e-xla/dodekaedri/README.md

# dodekaedri
dodekaedrin muotoinen radio ":D" /  dodecahedron shaped radio ":D"

------
This project aims to create truly affordable (<50€) 40m SSB QRP HAM radio kit.
Intention is to create such easy-approach kit that enables new (and old) HAMs to learn about radios, electronics and so on.

Some intended specs include:
* included SWR-meter
* ~5-10W of raw electromagnetic power
* graphical UI
* 2 mixer stages, one physical, one done with software

(Antenna not included)
