e-xla/dodekaedri/stm32/README

How to compile and program the STM32 software

Install arm-none-eabi-gcc, arm-none-eabi-binutils and arm-none-eabi-gdb.

Build stlink: https://github.com/texane/stlink

Download STM32F4 standard peripherals library: http://www.st.com/content/st_com/en/products/embedded-software/mcus-embedded-software/stm32-embedded-software/stm32-standard-peripheral-libraries/stsw-stm32065.html
Unzip the library and modify Makefile for the path to the library.

Run make

Start st-util: /path/to/stlink/build/st-util
arm-none-eabi-gdb dodekaedri.elf
Write these commands in gdb:
tar rem :4242
load
mon reset
continue
