e-xla/dodekaedri/hardware/dodekaedri.csv

Reference | Value | Footprint | Datasheet
R207 | 100R | Resistors_SMD:R_0805_HandSoldering
R205 | 100R | Resistors_SMD:R_0805_HandSoldering
R206 | 100R | Resistors_SMD:R_0805_HandSoldering
C202 | 100nF | Capacitors_SMD:C_0805_HandSoldering
C201 | 100nF | Capacitors_SMD:C_0805_HandSoldering
U201 | MIC5365 | TO_SOT_Packages_SMD:SOT-23-5
OSC201 | TCXO 26MHz | dodekaedri:TCXO_1.5x2mm
R201 | 1k | Resistors_SMD:R_0805_HandSoldering
R202 | 1k | Resistors_SMD:R_0805_HandSoldering
C203 | 1nF | Capacitors_SMD:C_0805_HandSoldering
C205 | 100nF | Capacitors_SMD:C_0805_HandSoldering
C204 | 100nF | Capacitors_SMD:C_0805_HandSoldering
U202 | SI5351A | Housings_SSOP:MSOP-10_3x3mm_Pitch0.5mm
R204 | 100R | Resistors_SMD:R_0805_HandSoldering
R203 | 100R | Resistors_SMD:R_0805_HandSoldering
P301 | BNC | dodekaedri:BNC_right_angle
C301 | 1nF | Capacitors_SMD:C_0805_HandSoldering
C302 | 1nF | Capacitors_SMD:C_0805_HandSoldering
L301 | 660nH | Air_Coils_SML_NEOSID:Neosid_Air-Coil_SML_5turn_HDM0531A
C304 | 1nF | Capacitors_SMD:C_0805_HandSoldering
C305 | 1nF | Capacitors_SMD:C_0805_HandSoldering
R302 | 47R | Resistors_SMD:R_0805_HandSoldering
R303 | 47R | Resistors_SMD:R_0805_HandSoldering
R301 | 7k87 | Resistors_SMD:R_0805_HandSoldering
D301 | BAT54SL | dodekaedri:SOT-23_HS_2-1-3
D302 | BAT54SL | dodekaedri:SOT-23_HS_2-1-3
D303 | BAT54SL | dodekaedri:SOT-23_HS_2-1-3
C307 | 1nF | Capacitors_SMD:C_0805_HandSoldering
C308 | 1nF | Capacitors_SMD:C_0805_HandSoldering
C309 | 100nF | Capacitors_SMD:C_0805_HandSoldering
C306 | 100nF | Capacitors_SMD:C_0805_HandSoldering
L303 | 1µ6 | Air_Coils_SML_NEOSID:Neosid_Air-Coil_SML_5turn_HDM0531A
D304 | BA891 | Diodes_SMD:SOD-523
R304 | 100k | Resistors_SMD:R_0805_HandSoldering
C311 | 330pF | Capacitors_SMD:C_0805_HandSoldering
D305 | BA891 | Diodes_SMD:SOD-523
R305 | 100R | Resistors_SMD:R_0805_HandSoldering
C310 | 10nF | Capacitors_SMD:C_0805_HandSoldering
L304 | 470µH | dodekaedri:SMT_1007
D306 | BA891 | Diodes_SMD:SOD-523
T302 | TRANSFO | dodekaedri:TRANSF_pads
T301 | TRANSFO | dodekaedri:TRANSF_pads
R307 | 1k | Resistors_SMD:R_0805_HandSoldering
R306 | 1k | Resistors_SMD:R_0805_HandSoldering
R308 | 1k | Resistors_SMD:R_0805_HandSoldering
R309 | 1k | Resistors_SMD:R_0805_HandSoldering
U401 | NCP3170-D | Housings_SOIC:SOIC-8_3.9x4.9mm_Pitch1.27mm
C403 | 6n8 | Capacitors_SMD:C_0805_HandSoldering
C402 | 10µF | Capacitors_SMD:C_0805_HandSoldering
C404 | 10µF | Capacitors_SMD:C_0805_HandSoldering
L402 | 100µH | dodekaedri:psu_ind
R403 | 24k9 | Resistors_SMD:R_0805_HandSoldering
R404 | 7k87 | Resistors_SMD:R_0805_HandSoldering
R402 | 4k99 | Resistors_SMD:R_0805_HandSoldering
CON401 | BARREL_JACK | Connect:BARREL_JACK
W401 | TEST_1P | Measurement_Points:Measurement_Point_Round-SMD-Pad_Big
C401 | 10µF | Capacitors_SMD:C_0805_HandSoldering
C405 | 10µF | Capacitors_SMD:C_0805_HandSoldering
R401 | 100k | Resistors_SMD:R_0805_HandSoldering
D401 | 824520141 | Diodes_SMD:SMA_Handsoldering
FB401 | FILTER | Resistors_SMD:R_0805_HandSoldering
FB402 | FILTER | Resistors_SMD:R_0805_HandSoldering
D402 | MSP3V3 | dodekaedri:Micro_SMP
U501 | 74LVC1G3157 | TO_SOT_Packages_SMD:SOT-23-6_Handsoldering
U502 | 74LVC1G3157 | TO_SOT_Packages_SMD:SOT-23-6_Handsoldering
T501 | TRANSFO2 | dodekaedri:transf_5_pin
C501 | 220µF | dodekaedri:CAP_6.3x5.8mm
C502 | 100nF | Capacitors_SMD:C_0805_HandSoldering
L501 | 1µH | Air_Coils_SML_NEOSID:Neosid_Air-Coil_SML_5turn_HDM0531A
C503 | 330pF | Capacitors_SMD:C_0805_HandSoldering
C504 | 10nF | Capacitors_SMD:C_0805_HandSoldering
Q501 | BCP56 | TO_SOT_Packages_SMD:SOT-223
R504 | 10R | Resistors_SMD:R_0805_HandSoldering
C505 | 100nF | Capacitors_SMD:C_0805_HandSoldering
C506 | 10nF | Capacitors_SMD:C_0805_HandSoldering
C507 | 10nF | Capacitors_SMD:C_0805_HandSoldering
R506 | 1k | Resistors_SMD:R_0805_HandSoldering
R505 | 0.1pF | Resistors_SMD:R_0805_HandSoldering
Q502 | IRL510 | TO_SOT_Packages_THT:TO-220_Neutral123_Vertical
L502 | 1µH | Air_Coils_SML_NEOSID:Neosid_Air-Coil_SML_5turn_HDM0531A
C509 | 100nF | Capacitors_SMD:C_0805_HandSoldering
R508 | 0R1 | Resistors_SMD:R_0805_HandSoldering
L503 | 800nH | Air_Coils_SML_NEOSID:Neosid_Air-Coil_SML_5turn_HDM0531A
C512 | 330pF | Capacitors_SMD:C_0805_HandSoldering
C513 | 1nF | Capacitors_SMD:C_0805_HandSoldering
R502 | 1k | Resistors_SMD:R_0805_HandSoldering
C511 | 10nF | Capacitors_SMD:C_0805_HandSoldering
R509 | 1k | Resistors_SMD:R_0805_HandSoldering
C508 | 10nF | Capacitors_SMD:C_0805_HandSoldering
C510 | 10nF | Capacitors_SMD:C_0805_HandSoldering
R507 | 1k | Resistors_SMD:R_0805_HandSoldering
R510 | 1k | Resistors_SMD:R_0805_HandSoldering
R501 | 1k | Resistors_SMD:R_0805_HandSoldering
FB501 | FILTER | Resistors_SMD:R_0805_HandSoldering
R511 | 100k | Resistors_SMD:R_0805_HandSoldering
D501 | RED | LEDs:LED_0805
R512 | 100R | Resistors_SMD:R_0805_HandSoldering
R513 | 100R | Resistors_SMD:R_0805_HandSoldering
C514 | 1nF | Capacitors_SMD:C_0805_HandSoldering
C515 | 1nF | Capacitors_SMD:C_0805_HandSoldering
FB502 | FILTER | Resistors_SMD:R_0805_HandSoldering
T601 | TRANSFO2 | dodekaedri:transf_5_pin
U601 | 74LVC1G3157 | TO_SOT_Packages_SMD:SOT-23-6_Handsoldering
U602 | 74LVC1G3157 | TO_SOT_Packages_SMD:SOT-23-6_Handsoldering
R601 | 100R | Resistors_SMD:R_0805_HandSoldering
R602 | 100R | Resistors_SMD:R_0805_HandSoldering
C602 | 68nF | Capacitors_SMD:C_0805_HandSoldering
C603 | 68nF | Capacitors_SMD:C_0805_HandSoldering
C605 | 68nF | Capacitors_SMD:C_0805_HandSoldering
C604 | 68nF | Capacitors_SMD:C_0805_HandSoldering
L601 | 470µH | dodekaedri:SMT_1007
L603 | 470µH | dodekaedri:SMT_1007
L602 | 470µH | dodekaedri:SMT_1007
L604 | 470µH | dodekaedri:SMT_1007
U603 | TL972IDR | Housings_SOIC:SOIC-8_3.9x4.9mm_Pitch1.27mm
R603 | 100R | Resistors_SMD:R_0805_HandSoldering
R604 | 100R | Resistors_SMD:R_0805_HandSoldering
C601 | 100nF | Capacitors_SMD:C_0805_HandSoldering
C606 | 1nF | Capacitors_SMD:C_0805_HandSoldering
C607 | 1nF | Capacitors_SMD:C_0805_HandSoldering
R605 | 1k | Resistors_SMD:R_0805_HandSoldering
R606 | 1k | Resistors_SMD:R_0805_HandSoldering
C608 | 100nF | Capacitors_SMD:C_0805_HandSoldering
U701 | WM8731 | Housings_SSOP:SSOP-28_5.3x10.2mm_Pitch0.65mm
C701 | 10µF | Capacitors_SMD:C_0805_HandSoldering
C702 | 10µF | Capacitors_SMD:C_0805_HandSoldering
C703 | 10µF | Capacitors_SMD:C_0805_HandSoldering
C704 | 10µF | Capacitors_SMD:C_0805_HandSoldering
R701 | 0.1pF | Resistors_SMD:R_0805_HandSoldering
R702 | 0.1pF | Resistors_SMD:R_0805_HandSoldering
C705 | 10µF | Capacitors_SMD:C_0805_HandSoldering
U702 | MCP6L02 | Housings_SOIC:SOIC-8_3.9x4.9mm_Pitch1.27mm
R703 | 1k | Resistors_SMD:R_0805_HandSoldering
R704 | 0R | Resistors_SMD:R_0805_HandSoldering
R705 | 0R | Resistors_SMD:R_0805_HandSoldering
C805 | 100nF | Capacitors_SMD:C_0805_HandSoldering
C807 | 100nF | Capacitors_SMD:C_0805_HandSoldering
C801 | 100nF | Capacitors_SMD:C_0805_HandSoldering
C810 | 100nF | Capacitors_SMD:C_0805_HandSoldering
C806 | 100nF | Capacitors_SMD:C_0805_HandSoldering
C809 | 100nF | Capacitors_SMD:C_0805_HandSoldering
C803 | 10µF | Capacitors_SMD:C_0805_HandSoldering
U802 | WM8731 | Housings_SSOP:SSOP-28_5.3x10.2mm_Pitch0.65mm
C812 | 10µF | Capacitors_SMD:C_0805_HandSoldering
C813 | 10µF | Capacitors_SMD:C_0805_HandSoldering
C814 | 10µF | Capacitors_SMD:C_0805_HandSoldering
C815 | 10µF | Capacitors_SMD:C_0805_HandSoldering
R810 | 0.1pF | Resistors_SMD:R_0805_HandSoldering
R811 | 0.1pF | Resistors_SMD:R_0805_HandSoldering
C818 | 10µF | Capacitors_SMD:C_0805_HandSoldering
R812 | 1k | Resistors_SMD:R_0805_HandSoldering
R816 | 1k | Resistors_SMD:R_0805_HandSoldering
R818 | 100R | Resistors_SMD:R_0805_HandSoldering
C819 | 220µF | dodekaedri:CAP_6.3x5.8mm
C816 | 220µF | dodekaedri:CAP_6.3x5.8mm
C817 | 1nF | Capacitors_SMD:C_0805_HandSoldering
C820 | 1nF | Capacitors_SMD:C_0805_HandSoldering
J801 | HANDSFREE | dodekaedri:TRRS_jack
J803 | HEADPHONES
J802 | microphone
R815 | 1k | Resistors_SMD:R_0805_HandSoldering
R814 | 1k | Resistors_SMD:R_0805_HandSoldering
R808 | 100k | Resistors_SMD:R_0805_HandSoldering
D814 | MSP3V3 | dodekaedri:Micro_SMP
C802 | 1nF | Capacitors_SMD:C_0805_HandSoldering
Q801 | BSS84 | TO_SOT_Packages_SMD:SOT-23_Handsoldering
R803 | 100k | Resistors_SMD:R_0805_HandSoldering
P801 | TX_SW_WIRE | Connect:AK300-2
SW801 | SW_PUSH | Buttons_Switches_SMD:SW_SPST_B3SL-1002P
R801 | 100k | Resistors_SMD:R_0805_HandSoldering
C804 | 1nF | Capacitors_SMD:C_0805_HandSoldering
R802 | 1k | Resistors_SMD:R_0805_HandSoldering
R804 | 1k | Resistors_SMD:R_0805_HandSoldering
D801 | BAT54SL | TO_SOT_Packages_SMD:SOT-23_Handsoldering
D803 | BAT54SL | TO_SOT_Packages_SMD:SOT-23_Handsoldering
D804 | BAT54SL | TO_SOT_Packages_SMD:SOT-23_Handsoldering
FB802 | FILTER | Resistors_SMD:R_0805_HandSoldering
FB803 | FILTER | Resistors_SMD:R_0805_HandSoldering
FB801 | FILTER | Resistors_SMD:R_0805_HandSoldering
D805 | BAT54SL | dodekaedri:SOT-23_HS_2-1-3
D806 | BAT54SL | dodekaedri:SOT-23_HS_2-1-3
D807 | BAT54SL | dodekaedri:SOT-23_HS_2-1-3
SW802 | SW | Buttons_Switches_SMD:SW_SPST_B3SL-1002P
SW803 | SW | Buttons_Switches_SMD:SW_SPST_B3SL-1002P
SW804 | SW | Buttons_Switches_SMD:SW_SPST_B3SL-1002P
D809 | BAT54SL | dodekaedri:SOT-23_HS_2-1-3
D812 | BAT54SL | dodekaedri:SOT-23_HS_2-1-3
D810 | BAT54SL | dodekaedri:SOT-23_HS_2-1-3
SW806 | encoder | dodekaedri:encoder
R806 | 1k | Resistors_SMD:R_0805_HandSoldering
R809 | 1k | Resistors_SMD:R_0805_HandSoldering
P806 | CONN_01X08 | Pin_Headers:Pin_Header_Straight_1x08
U801 | STM32F401 | Housings_QFP:LQFP-64_10x10mm_Pitch0.5mm
P807 | CONN_01X04 | Pin_Headers:Pin_Header_Straight_1x04
P808 | CONN_02X04 | Pin_Headers:Pin_Header_Straight_2x04
R819 | 100R | Resistors_SMD:R_0805_HandSoldering
C808 | 10µF | Capacitors_SMD:C_0805_HandSoldering
C811 | 10µF | Capacitors_SMD:C_0805_HandSoldering
R820 | 1k | Resistors_SMD:R_0805_HandSoldering
R821 | 1k | Resistors_SMD:R_0805_HandSoldering
R805 | 100k | Resistors_SMD:R_0805_HandSoldering
P809 | BOOT0JMPR | Pin_Headers:Pin_Header_Straight_1x02
R807 | 100k | Resistors_SMD:R_0805_HandSoldering
SW807 | RESET | Buttons_Switches_SMD:SW_SPST_B3SL-1002P
P803 | UART | Pin_Headers:Pin_Header_Straight_1x02
P804 | PROG | Pin_Headers:Pin_Header_Straight_1x02
P805 | RNG_PINS | Pin_Headers:Pin_Header_Straight_2x08
D802 | PMEG6020EP | Diodes_SMD:D_0805
D823 | BAT54SL | TO_SOT_Packages_SMD:SOT-23_Handsoldering
R830 | 1k | Resistors_SMD:R_0805_HandSoldering
R831 | 1k | Resistors_SMD:R_0805_HandSoldering
R832 | 1k | Resistors_SMD:R_0805_HandSoldering
R833 | 1k | Resistors_SMD:R_0805_HandSoldering
R834 | 1k | Resistors_SMD:R_0805_HandSoldering
R835 | 1k | Resistors_SMD:R_0805_HandSoldering
R825 | 1k | Resistors_SMD:R_0805_HandSoldering
R826 | 1k | Resistors_SMD:R_0805_HandSoldering
R827 | 1k | Resistors_SMD:R_0805_HandSoldering
R828 | 1k | Resistors_SMD:R_0805_HandSoldering
D819 | BAT54SL | TO_SOT_Packages_SMD:SOT-23_Handsoldering
D820 | BAT54SL | TO_SOT_Packages_SMD:SOT-23_Handsoldering
D822 | BAT54SL | TO_SOT_Packages_SMD:SOT-23_Handsoldering
D821 | BAT54SL | TO_SOT_Packages_SMD:SOT-23_Handsoldering
R823 | 100R | Resistors_SMD:R_0805_HandSoldering
R824 | 100R | Resistors_SMD:R_0805_HandSoldering
D818 | BAT54SL | TO_SOT_Packages_SMD:SOT-23_Handsoldering
P802 | USB_OTG | Connect:USB_Micro-B
R822 | 7k87 | Resistors_SMD:R_0805_HandSoldering
R813 | 100k | Resistors_SMD:R_0805_HandSoldering
