e-xla/dodekaedri/hardware/bom_v1.ods

Value | Count | devices | count multi | handled | Multi price | total | References | Mouser (old) | New | (alternative) | Nice to have features / comments
0.1pF | 5 | 25 | 125 | x | 0 | 0 | R505" "R701" "R702" "R810" "R811
0R | 2 | 25 | 50 | 100 | 0 | 0 | R704" "R705 | 667-ERJ-6GEY0R00V | 667-ERJ-6GEY0R00V (http://www.mouser.fi/ProductDetail/Panasonic/ERJ-6GEY0R00V/?qs=sGAEpiMZZMtlubZbdhIBIGGkozl1QdRpbM2mlUXXIDw%3D)
0R1 | 1 | 25 | 25 | 100 | 0 | 0 | R508 | 774-73L3R10J | 774-73L3R10J (http://www.mouser.fi/ProductDetail/CTS-Electronic-Components/73L3R10J/)
100R | 16 | 25 | 400 | 1000 | 0 | 0 | R207" "R205" "R206" "R204" "R203" "R305" "R512" "R513" "R601" "R602" "R603" "R604" "R818" "R819" "R823" "R824 | 588-AS08J1000ET | 755-ESR10EZPJ101 (http://www.mouser.fi/ProductDetail/ROHM-Semiconductor/ESR10EZPJ101/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)
100k | 9 | 25 | 225 | 300 | 0 | 0 | R304" "R401" "R511" "R808" "R803" "R801" "R805" "R807" "R813 | 588-AS08J1003ET | 603-RC0805JR-07100KL (http://www.mouser.fi/ProductDetail/Yageo/RC0805JR-07100KL/?qs=sGAEpiMZZMtlubZbdhIBILYKDyqiSVLql9IYbXdvrms%3D)
100nF | 17 | 25 | 425 | k | 0 | 0 | C202" "C201" "C205" "C204" "C309" "C306" "C502" "C505" "C509" "C601" "C608" "C805" "C807" "C801" "C810" "C806" "C809 | 710-885012207072 | from club
100µH | 1 | 25 | 25 | 10 | 0 | 0 | L402 | ASPI-4030S-101M-T | out of stock :( | 652-SRN4018-101M (http://www.mouser.fi/ProductDetail/Bourns/SRN4018-101M/)
10R | 1 | 25 | 25 | k | 0 | 0 | R504 | 588-AS08J10R0ET | from club (8.2R)
10nF | 7 | 25 | 175 | k | 0 | 0 | C310" "C504" "C506" "C507" "C511" "C508" "C510 | 710-885012207011 | from club
10µF | 17 | 25 | 425 | 100 | 0 | 0 | C402" "C404" "C401" "C405" "C701" "C702" "C703" "C704" "C705" "C803" "C812" "C813" "C814" "C815" "C818" "C808" "C811 | 81-GRM21BR61A106KE19 | 81-GRM21BR61A106KE19 (http://www.mouser.fi/ProductDetail/Murata-Electronics/GRM21BR61A106KE19L/)
1k | 35 | 25 | 875 | 1000 | 0 | 0 | R201" "R202" "R307" "R306" "R308" "R309" "R506" "R502" "R509" "R507" "R510" "R501" "R605" "R606" "R703" "R812" "R816" "R815" "R814" "R802" "R804" "R806" "R809" "R820" "R821" "R830" "R831" "R832" "R833" "R834" "R835" "R825" "R826" "R827" "R828 | 588-AS08J1001ET | 603-RC0805FR-071KL (http://www.mouser.fi/ProductDetail/Yageo/RC0805FR-071KL/?qs=sGAEpiMZZMu61qfTUdNhG0IfGdGRhTL5jwjd7Z4phgo%3D)
1nF | 16 | 25 | 400 | 500 | 0 | 0 | C203" "C301" "C302" "C304" "C305" "C307" "C308" "C513" "C514" "C515" "C606" "C607" "C817" "C820" "C802" "C804 | 581-08053F102K4T2A | 581-08055A102J (http://www.mouser.fi/ProductDetail/AVX/08055A102JAT2A/) |  | NP0
1µ6 | 1 | 25 | 25 | k | 0 | 0 | L303 |  | homewound
1µH | 2 | 25 | 50 | k | 0 | 0 | L501" "L502 |  | homewound
220µF | 3 | 25 | 75 | 100 | 0 | 0 | C501" "C819" "C816 | 647-UUR1A221MCL6GS | 647-UUR1A221MCL6GS (http://www.mouser.fi/ProductDetail/Nichicon/UUR1A221MCL6GS/)
24k9 | 1 | 25 | 25 | 100 | 0 | 0 | R403 | 71-CRCW0805-24.9K-E3 | 603-RC0805FR-0724K9L (http://www.mouser.fi/ProductDetail/Yageo/RC0805FR-0724K9L/?qs=sGAEpiMZZMtlubZbdhIBIJv49G1poxg99uEn6bmXK1I%3D) |  | 1,00%
330pF | 3 | 25 | 75 | k | 0 | 0 | C311" "C503" "C512 | 80-C0805C331K5R | from club |  | NP0
470µH | 5 | 25 | 125 | 0 | 0 | 0 | L304" "L601" "L603" "L602" "L604 | LB2518T471K | 963-LB2518T471K (http://www.mouser.fi/ProductDetail/Taiyo-Yuden/LB2518T471K/)
47R | 2 | 25 | 50 | 100 | 0 | 0 | R302" "R303 | 755-ESR10EZPJ470 | ( 603-RC0805FR-0747RL ) (http://www.mouser.fi/ProductDetail/Yageo/RC0805FR-0747RL/) | RC0805FR-0751RL (51ohm, better) (http://www.mouser.fi/ProductDetail/Yageo/RC0805FR-0751RL/?qs=sGAEpiMZZMtlubZbdhIBIKnsynxCetJ5q2IVS85if1M%3D) | changed to 51 ohm
4k99 | 1 | 25 | 25 | 100 | 0 | 0 | R402 | 667-ERJ-6ENF4991V | 603-RC0805FR-074K99L (http://www.mouser.fi/ProductDetail/Yageo/RC0805FR-074K99L/) |  | 1,00%
660nH | 1 | 25 | 25 | k | 0 | 0 | L301 |  | homewound
68nF | 4 | 25 | 100 | 100 | 0 | 0 | C602" "C603" "C605" "C604 | 710-885012207097 |  | 810-CGA4J1C0G2A333J2 (http://www.mouser.fi/ProductDetail/TDK/CGA4J1C0G2A333J125AC/) | NP0 → changed to 33 nF
6n8 | 1 | 25 | 25 | 10 | 0 | 0 | C403 | 08051C682KAT2A | 810-C2012C0G1H682J-1 (http://www.mouser.fi/ProductDetail/TDK/C2012C0G1H682J060AA/) |  | (NP0?)
74LVC1G3157 | 4 | 25 | 100 | 10 | 0 | 0 | U501" "U502" "U601" "U602 | SN74LVC1G3157DBVR | 621-74LVC1G3157DW-7 (http://www.mouser.fi/ProductDetail/Diodes-Incorporated/74LVC1G3157DW-7/)
7k87 | 3 | 25 | 75 | 100 | 0 | 0 | R301" "R404" "R822 | 603-RC0805FR-077K87L | 603-RC0805FR-077K87L (http://www.mouser.fi/ProductDetail/Yageo/RC0805FR-077K87L/) |  | 1,00%
800nH | 1 | 25 | 25 | k | 0 | 0 | L503 |  | homewound
824520141 | 1 | 25 | 25 | 10 | 0 | 0 | D401 | 824520141 | 710-824520141 (http://www.mouser.fi/ProductDetail/Wurth-Electronics/824520141/)
BA891 | 3 | 25 | 75 | 10 | 0 | 0 | D304" "D305" "D306 |  | 771-BA891-T/R (http://www.mouser.fi/ProductDetail/NXP-Semiconductors/BA891115/)
BARREL_JACK | 1 | 25 | 25 | 1 | 0 | 0 | CON401 | PJ-002A | 490-PJ-002A (http://www.mouser.fi/ProductDetail/CUI/PJ-002A/)
BAT54SL | 18 | 25 | 450 | 100 | 0 | 0 | D301" "D302" "D303" "D801" "D803" "D804" "D805" "D806" "D807" "D809" "D812" "D810" "D823" "D819" "D820" "D822" "D821" "D818 | BAT54SLT1G | 863-BAT54SLT1G (http://www.mouser.fi/ProductDetail/ON-Semiconductor/BAT54SLT1G/)
BCP56 | 1 | 25 | 25 | 4 | 0 | 0 | Q501 | BCP56 |  | 771-PZT2222A115 (faster) (http://www.mouser.fi/ProductDetail/NXP-Semiconductors/PZT2222A115/)
BNC | 1 | 25 | 25 | 1 | 0 | 0 | P301 | 112416 | 523-112416 (http://www.mouser.fi/ProductDetail/Amphenol-RF/112416/) | TME 1-1337494-0
BOOT0JMPR | 1 | 25 | 25 | ? | 0 | 0 | P809 |  | piikkirimaa!
BSS84 | 1 | 25 | 25 | 4 | 0 | 0 | Q801 | BSS84 | 726-BSS84PH6327XTSA2 (http://www.mouser.fi/ProductDetail/Infineon-Technologies/BSS84PH6327XTSA2/)
CONN_01X04 | 1 | 25 | 25 | ? | 0 | 0 | P807 |  | piikkirimaa!
CONN_01X08 | 1 | 25 | 25 | ? | 0 | 0 | P806 |  | piikkirimaa!
CONN_02X04 | 1 | 25 | 25 | ? | 0 | 0 | P808 |  | piikkirimaa!
FILTER | 7 | 25 | 175 | 0 | 0 | 0 | FB401" "FB402" "FB501" "FB502" "FB802" "FB803" "FB801 | 2508056007Y3 | 623-2508056007Y3 (http://www.mouser.fi/ProductDetail/Fair-Rite/2508056007Y3/?qs=sGAEpiMZZMtdyQheitOmRdlbrKoV7Kcr1qkGgD009vc%3D)
HANDSFREE | 1 | 25 | 25 | 1 | 0 | 0 | J801 | SJ-43515TS | 490-SJ-43515TS (http://www.mouser.fi/ProductDetail/CUI/SJ-43515TS/)
HEADPHONES | 0 | 25 | 0 | 0 | 0 | 0 | J803 |  | not in current layout
IRL510 | 1 | 25 | 25 | 5 | 0 | 0 | Q502 | IRL510 | 844-IRL510PBF (http://www.mouser.fi/ProductDetail/Vishay-Semiconductors/IRL510PBF/)
MCP6L02 | 1 | 25 | 25 | 3 | 0 | 0 | U702 | MCP6L02T-E/SN | 579-MCP6L02T-E/SN (http://www.mouser.fi/ProductDetail/Microchip-Technology/MCP6L02T-E-SN/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) | ( 579-MCP6002T-I/SN ) (http://www.mouser.fi/ProductDetail/Microchip-Technology/MCP6002T-I-SN/)
MIC5365 | 0 | 25 | 0 | 0 | 0 | 0 | U201 |  | not needed anymore
MSP3V3 | 2 | 25 | 50 | 10 | 0 | 0 | D402" "D814 | MSP3V3-M3/89A | 625-MSP3V3-M3 (http://www.mouser.fi/ProductDetail/Vishay-Semiconductors/MSP3V3-M3-89A/)
NCP3170-D | 1 | 25 | 25 | 2 | 0 | 0 | U401 | NCP3170ADR2G | 863-NCP3170ADR2G (http://www.mouser.fi/ProductDetail/ON-Semiconductor/NCP3170ADR2G/?qs=sGAEpiMZZMubXWjzskHvc9vqwOVbsQe%2F)
PMEG6020EP | 1 | 25 | 25 | 2 | 0 | 0 | D802 | PMEG6020EPASX | 581-SD0805S020S1R0 (http://www.mouser.fi/ProductDetail/AVX/SD0805S020S1R0/)
PROG | 1 | 25 | 25 | ? | 0 | 0 | P804 |  | piikkirimaa!
RED | 1 | 25 | 25 | 10 | 0 | 0 | D501 | HSMH-C170 | 604-AP2012EC (http://www.mouser.fi/ProductDetail/Kingbright/AP2012EC/?qs=sGAEpiMZZMseGfSY3csMkfJS7xWFNN5nHOYjTU5HAhY%3D)
RESET | 0 | 25 | 0 | 0 | 0 | 0 | SW807 | LL3301DF065QJ | included in SW
RNG_PINS | 1 | 25 | 25 | ? | 0 | 0 | P805 |  | piikkirimaa!
SI5351A | 1 | 25 | 25 | 4 | 0 | 0 | U202 | 634-SI5351A-B-GT | 634-SI5351A-B-GT (http://www.mouser.fi/ProductDetail/Silicon-Labs/SI5351A-B-GT/)
STM32F401 | 1 | 25 | 25 | 2 | 0 | 0 | U801 | STM32F401RE | 511-STM32F401RET6 (http://www.mouser.fi/ProductDetail/STMicroelectronics/STM32F401RET6/)
SW | 5 | 25 | 125 | 3 | 0 | 0 | SW802" "SW803" "SW804 | LL3301DF065QJ | 612-LL3301DF065QJ (http://www.mouser.fi/ProductDetail/E-Switch/LL3301DF065QJ/?qs=sGAEpiMZZMvxtGF7dlGNpqqmTFthXBmf2IHkMbm6UkQ%3D) |  | Includes RESET and SW_PUSH | tilattaneen tme_ltä !!
SW_PUSH | 0 | 25 | 0 | 0 | 0 | 0 | SW801 | LL3301DF065QJ | included in SW
TCXO 26MHz | 1 | 25 | 25 | 3 | 0 | 0 | OSC201 | KT2520K26000ZAW18TAS | 581-KT2520K2ACW18TAS (http://www.mouser.fi/ProductDetail/AVX-Kyocera/KT2520K26000ACW18TAS/)
TEST_1P | 0 | 25 | 0 | 0 | 0 | 0 | W401 |  | not a component
TL972IDR | 1 | 25 | 25 | 0 | 0 | 0 | U603 | TL972IDR | 595-TL972IDR (http://www.mouser.fi/ProductDetail/Texas-Instruments/TL972IDR/)
TRANSFO | 2 | 25 | 50 | 100 | 0 | 0 | T302" "T301 |  | 623-5943000101 + homewound (http://www.mouser.fi/ProductDetail/Fair-Rite/5943000101/)
TRANSFO2 | 2 | 25 | 50 | 0 | 0 | 0 | T501" "T601 | ETC4-1-2TR | 937-ETC4-1-2TR (http://www.mouser.fi/ProductDetail/MACOM/ETC4-1-2TR/) | partcon tarjous
TX_SW_WIRE | 0 | 25 | 0 | 0 | 0 | 0 | P801 |  | optional, not included
UART | 1 | 25 | 25 | ? | 0 | 0 | P803 |  | piikkirimaa!
USB_OTG | 1 | 25 | 25 | 2 | 0 | 0 | P802 | 538-67503-1020 | 538-67503-1020 (http://www.mouser.fi/ProductDetail/Molex/67503-1020/)
WM8731 | 2 | 25 | 50 | 4 | 0 | 0 | U701" "U802 | WM8731SEDS/V | 238-WM8731SEDS/V (http://www.mouser.fi/ProductDetail/Cirrus-Logic/WM8731SEDS-V/?qs=sGAEpiMZZMthNezIpKscMWquczdXLZMI)
encoder | 1 | 25 | 25 | 2 | 0 | 0 | SW806 | EN12-HS22AF20 | 858-EN12-HS22AF20 (http://www.mouser.fi/ProductDetail/BI-Technologies-TT-Electronics/EN12-HS22AF20/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)
microphone | 0 | 25 | 0 | 0 | 0 | 0 | J802 |  | not in current layout
knob | 1 | 25 | 25 | 1 | 0 | 0 | ?? |  | 706-11K5014-KCNG (http://www.mouser.fi/Search/ProductDetail.aspx) | etsitään halvempaa, muuten tämä
