e-xla/dodekaedri/pcb_plots/dodekaedri-F.SilkS.pdf

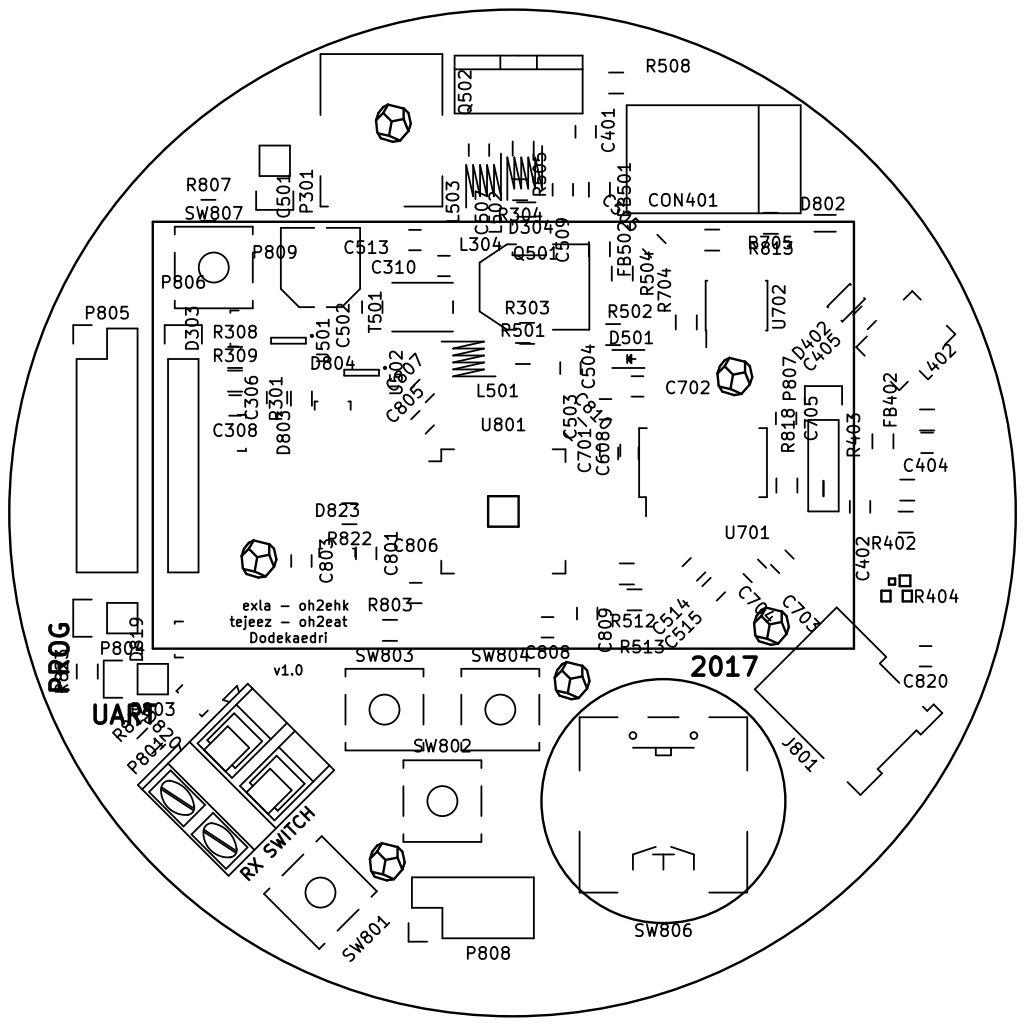
[picture p1: page 1]

tejeez - oh2eat Dodekaedri v1.0 RX SWITCH UART PROG
