e-xla/dodekaedri/pcb_plots/dodekaedri.pdf

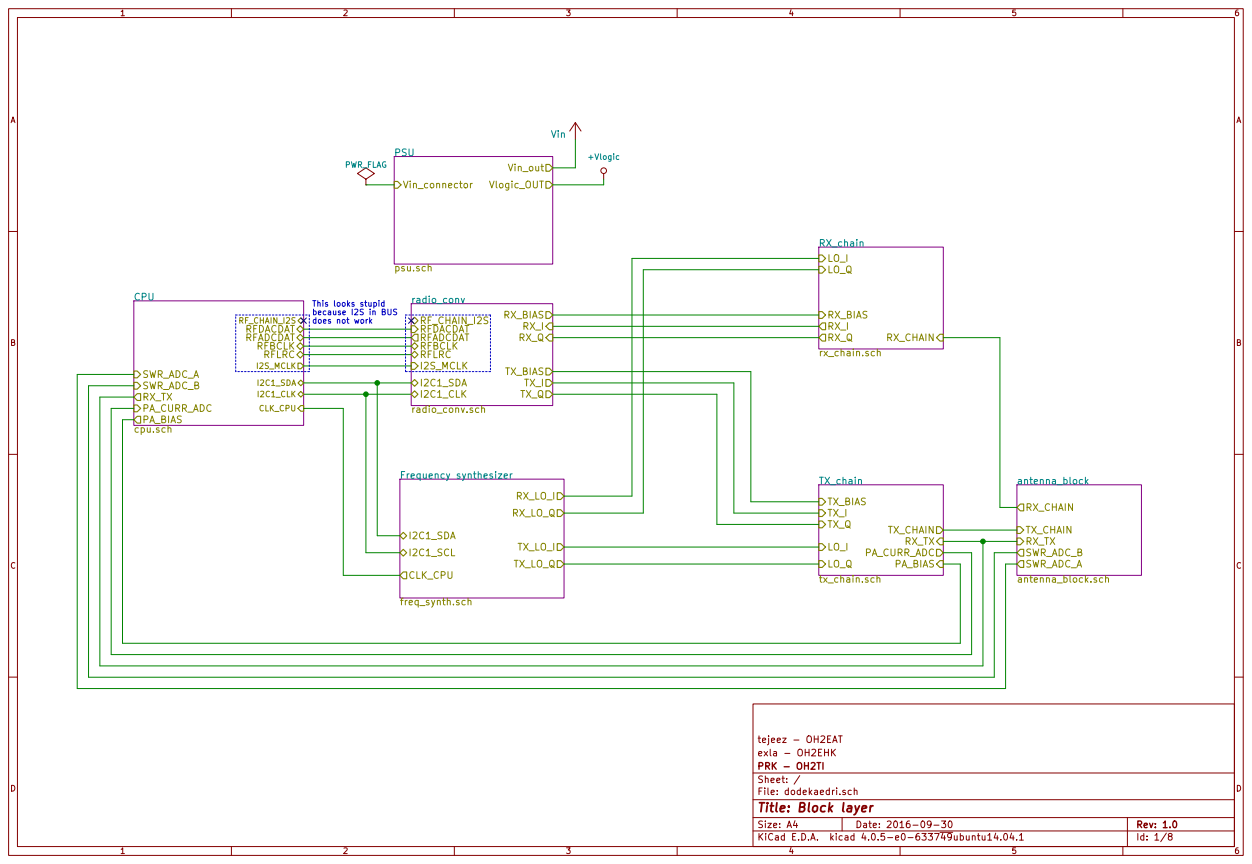
[picture p2: page 1]

tejeez - OH2EAT
Id: 1/8 Title: Block layer File: dodekaedri.sch Sheet: / PRK - OH2TI exla - OH2EHK

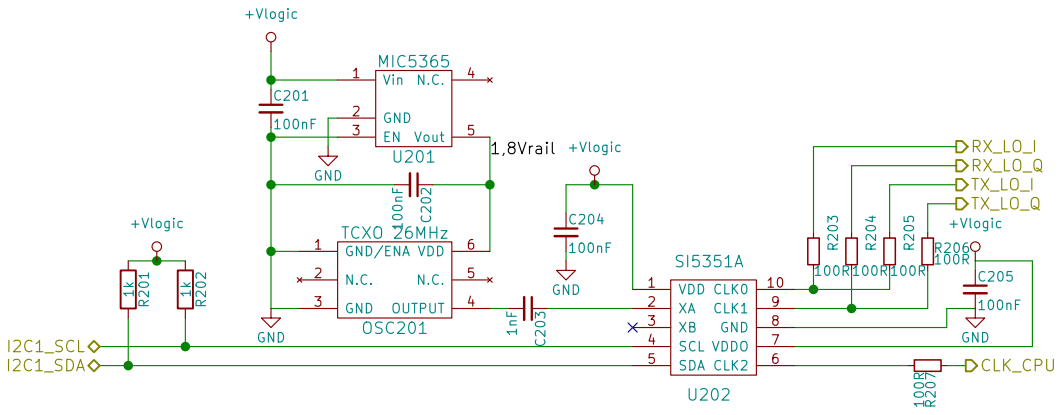
[picture p3: page 2]

tejeez - OH2EAT
Sheet: /Frequency synthesizer/ PRK - OH2TI exla - OH2EHK

File: freq_synth.sch
Id: 2/8 Title: Frequency synthesizer for LOs and CPU clock generation

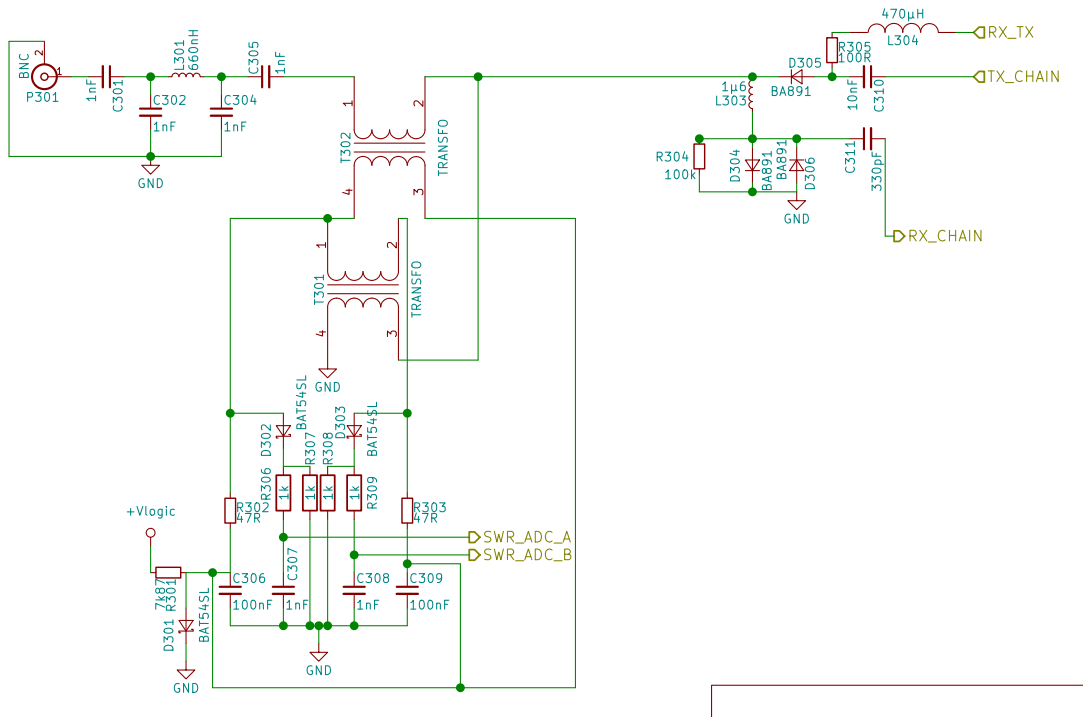
[picture p4: page 3]

File: antenna_block.sch
Id: 3/8 Title: Antenna block, SWR-meter and RXTX switch

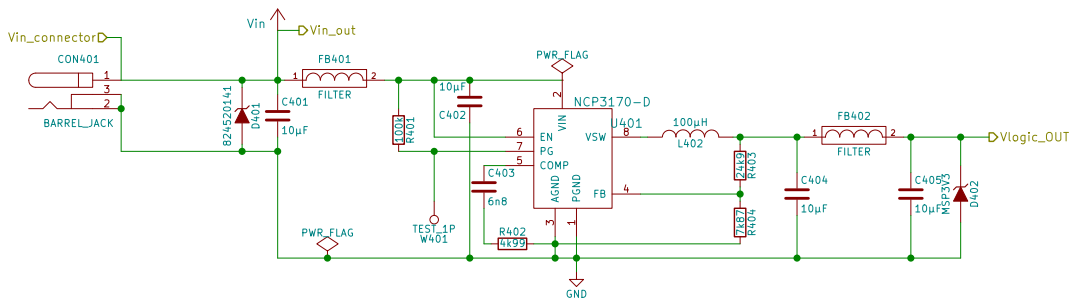
[picture p5: page 4]

3 FB 4 COMP 5 EN 6 PG 7 VSW 8 U401 NCP3170-D

File: psu.sch Sheet: /PSU/ PRK - OH2TI exla - OH2EHK

Id: 4/8 Title: Power supply unit

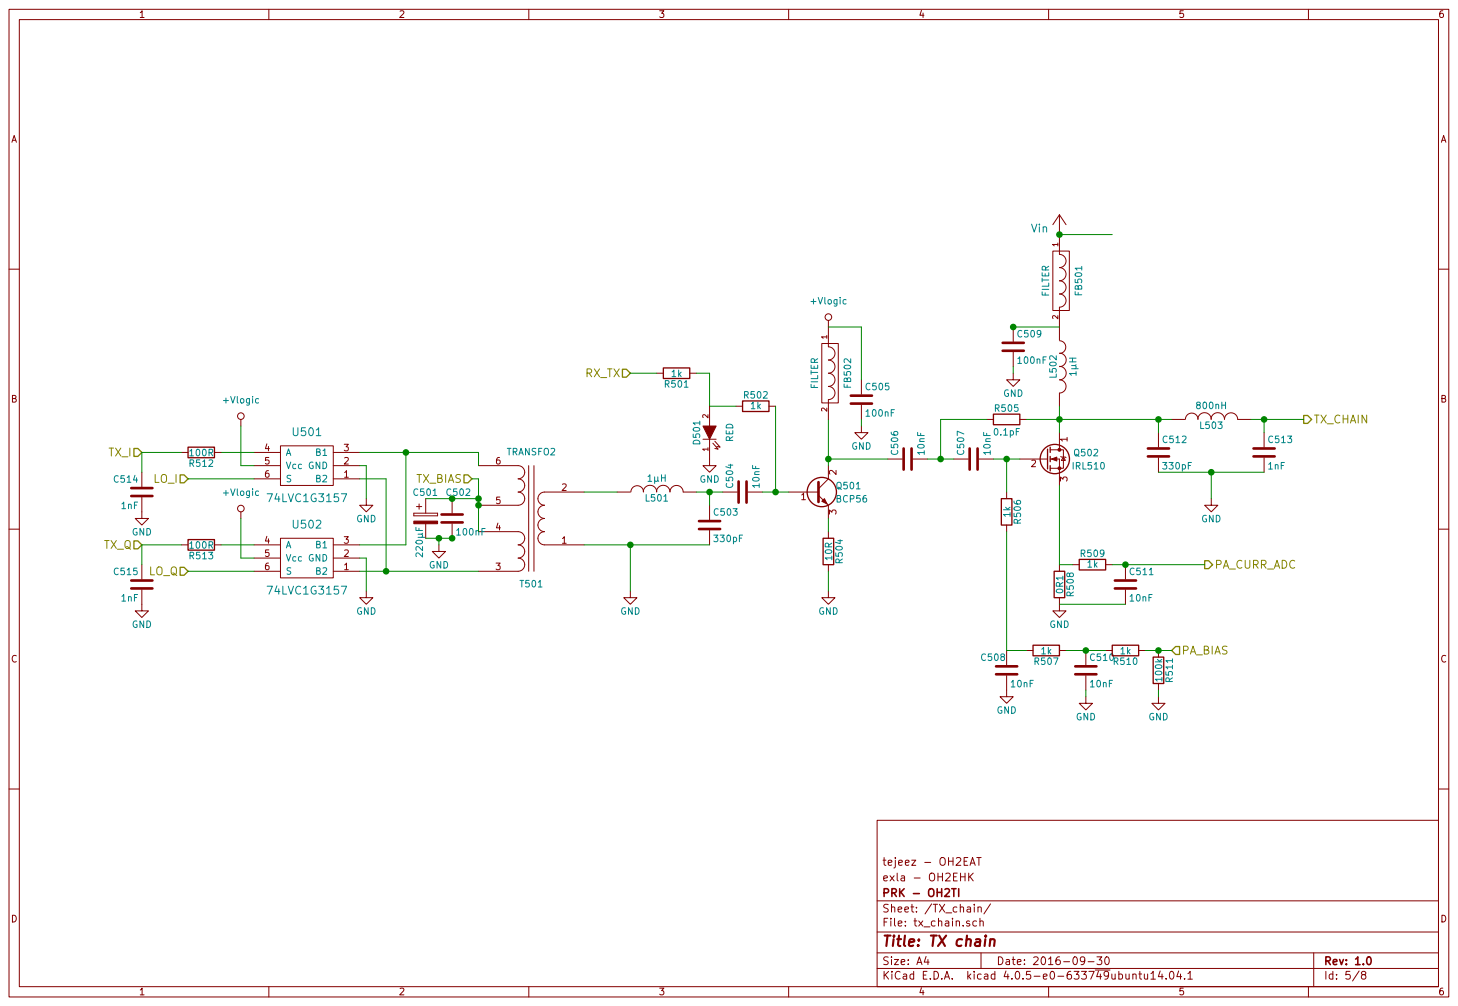
[picture p6: page 5]

File: tx_chain.sch
Id: 5/8 Title: TX chain

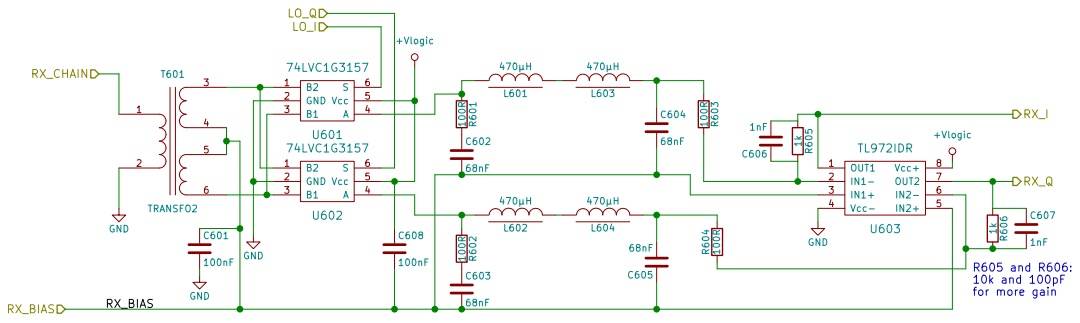
[picture p7: page 6]

File: rx_chain.sch
Id: 6/8 Title: RX chain

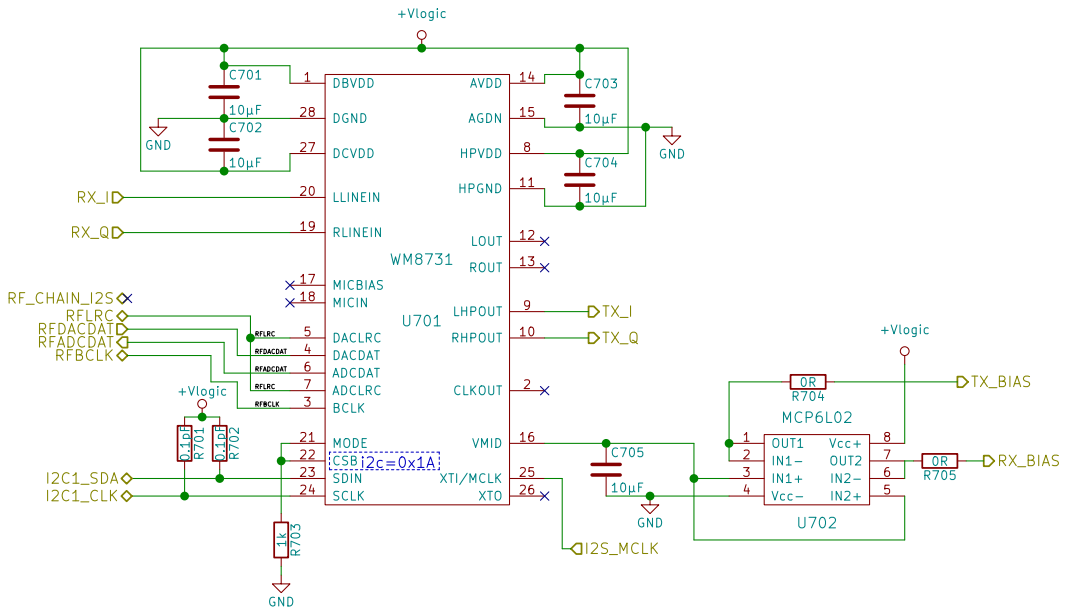
[picture p8: page 7]

File: radio_conv.sch
Id: 7/8 Title: RF chain ADC/DAC

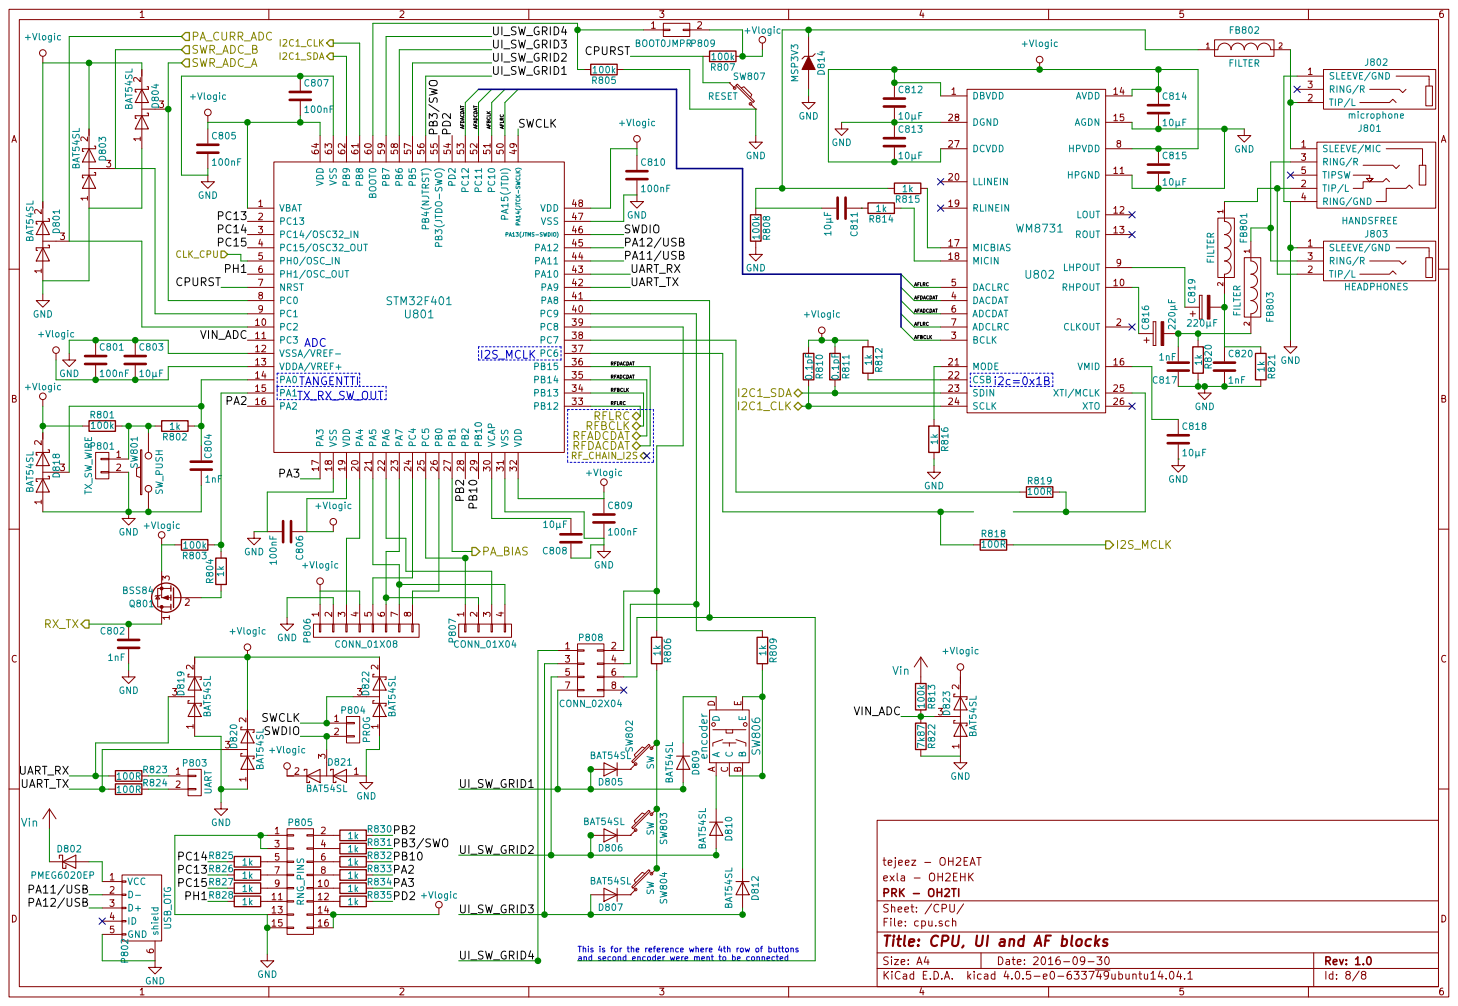
[picture p9: page 8]

TANGENTTI
TX_RX_SW_OUT

tejeez - OH2EAT
File: cpu.sch Sheet: /CPU/ PRK - OH2TI exla - OH2EHK

Id: 8/8 Title: CPU, UI and AF blocks
