e-xla/dodekaedri/pcb_plots/dodekaedri-B.Cu.pdf

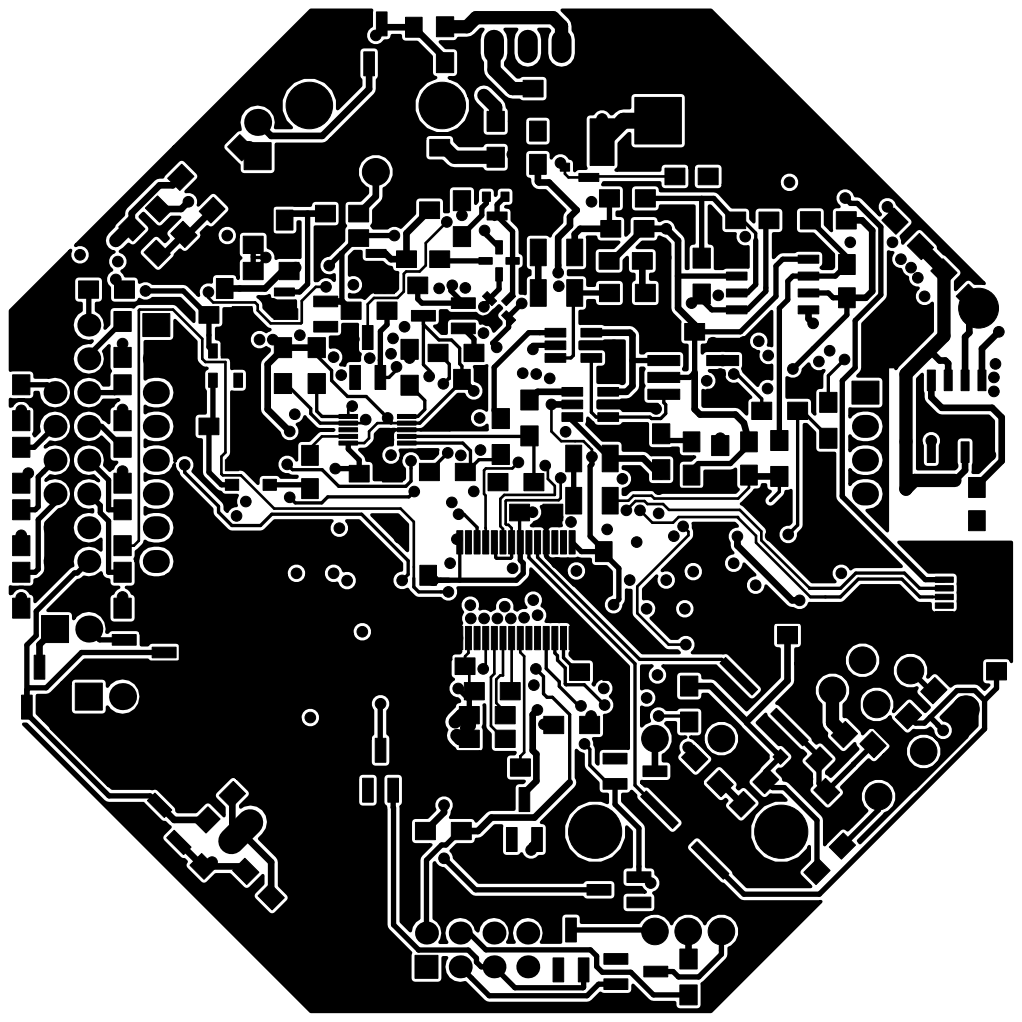
[picture p10: page 1]
