e-xla/dodekaedri/pcb_plots/dodekaedri-B.SilkS.pdf

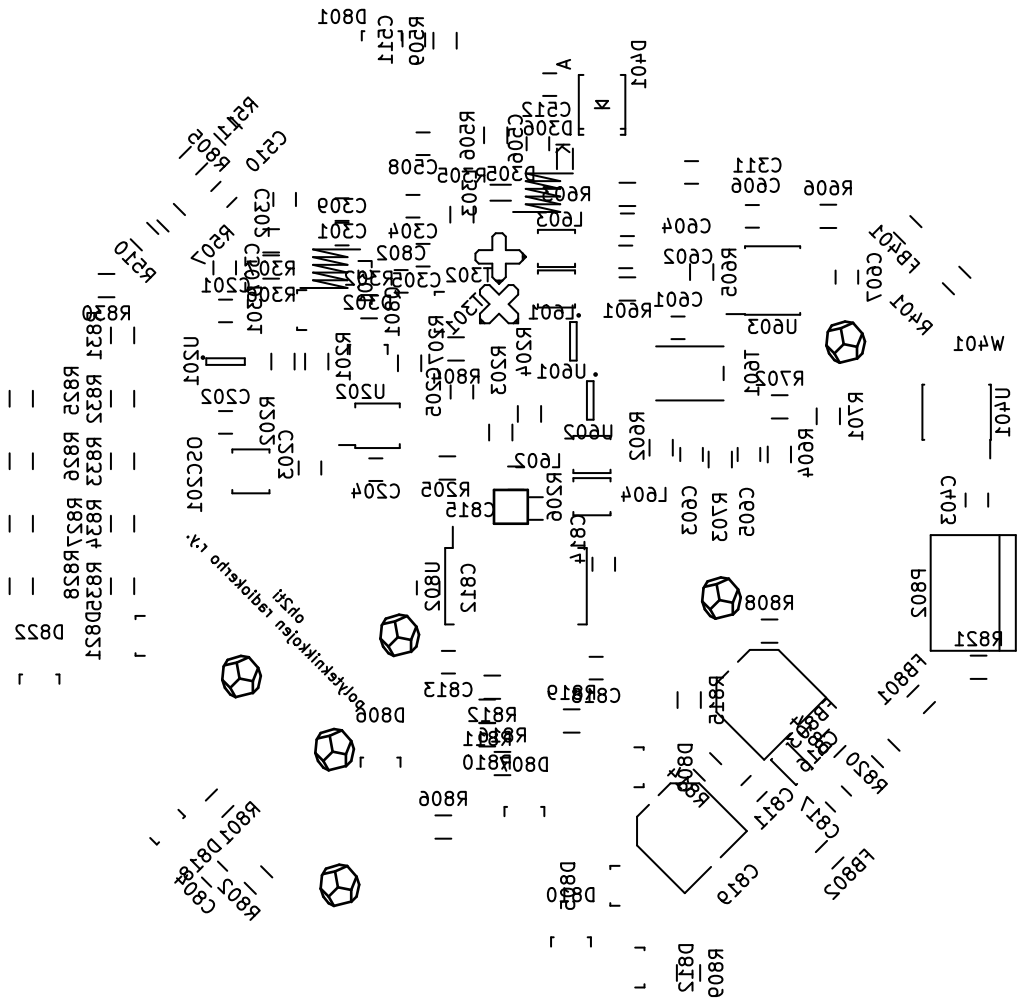
[picture p11: page 1]
