e-xla/dodekaedri/pcb_plots/dodekaedri-F.Cu.pdf

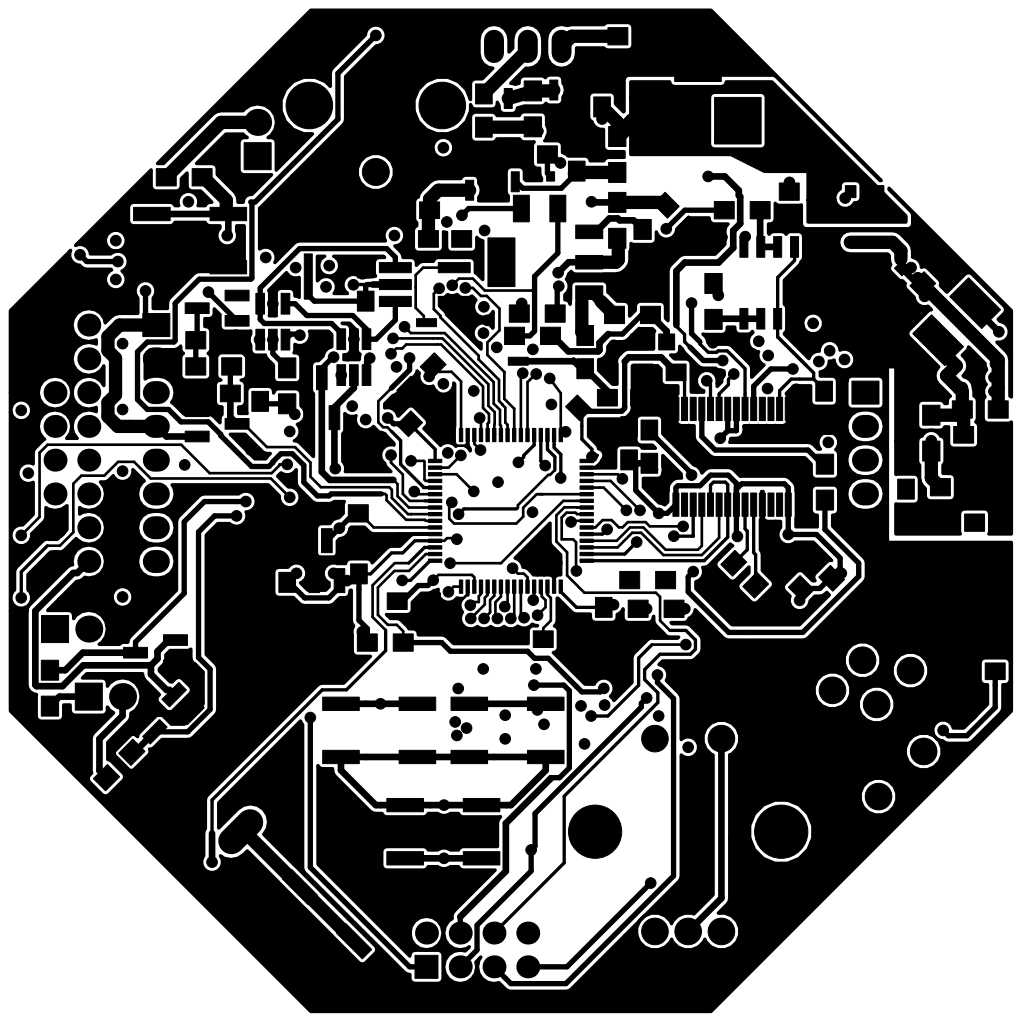
[picture p12: page 1]
