e-xla/dodekaedri/pcb_plots/dodekaedri-In1.Cu.pdf

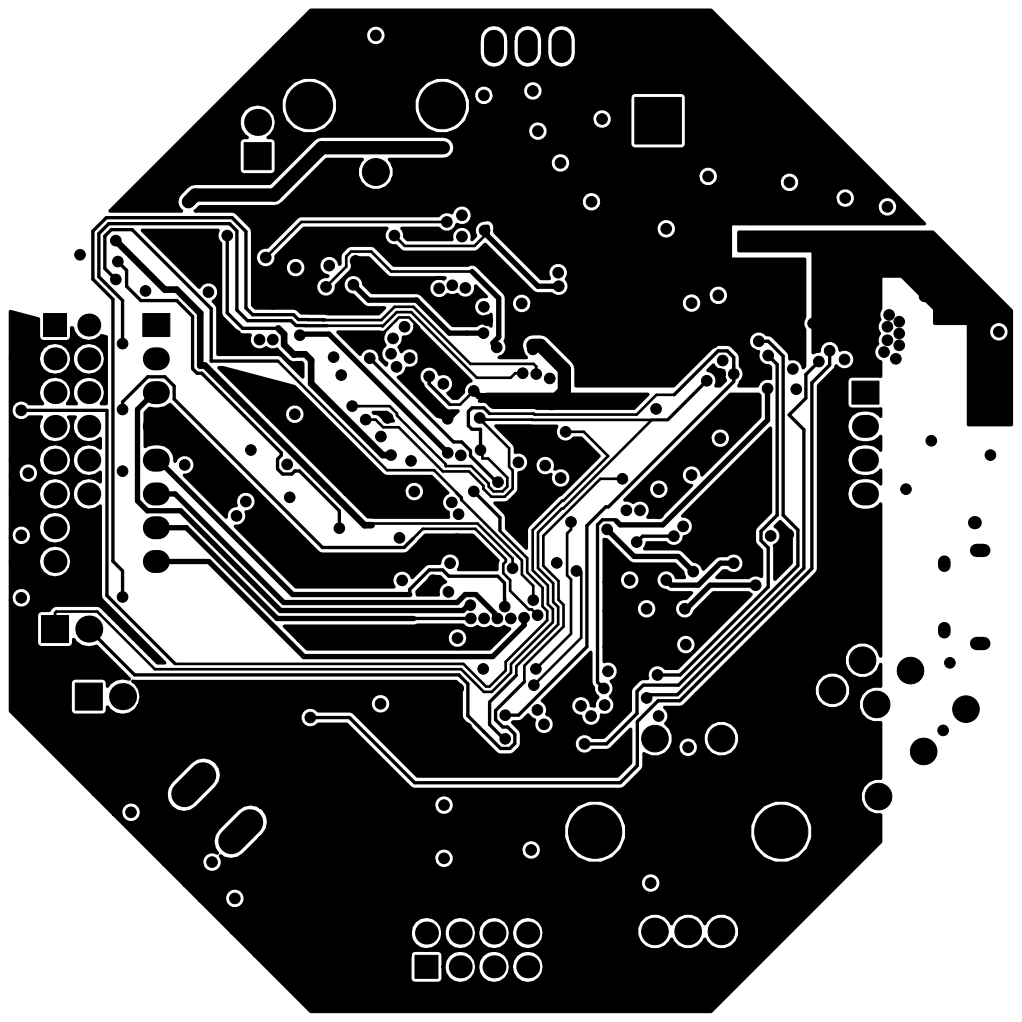
[picture p13: page 1]
