e-xla/dodekaedri/pcb_plots/dodekaedri-In2.Cu.pdf

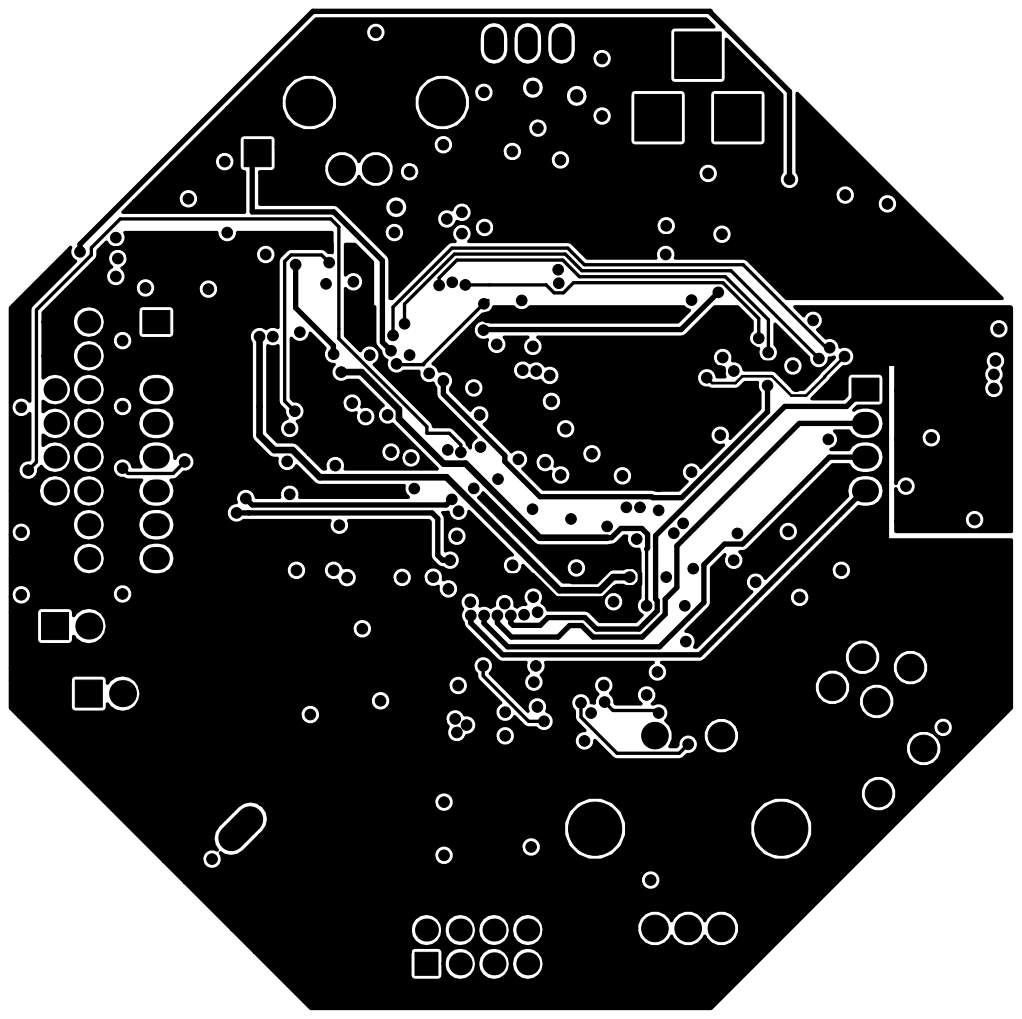
[picture p14: page 1]
