e-xla/dodekaedri/hardware/dodekaedri.kicad_pcb

## KiCad design hardware/dodekaedri.kicad_pcb (2017-01-23)

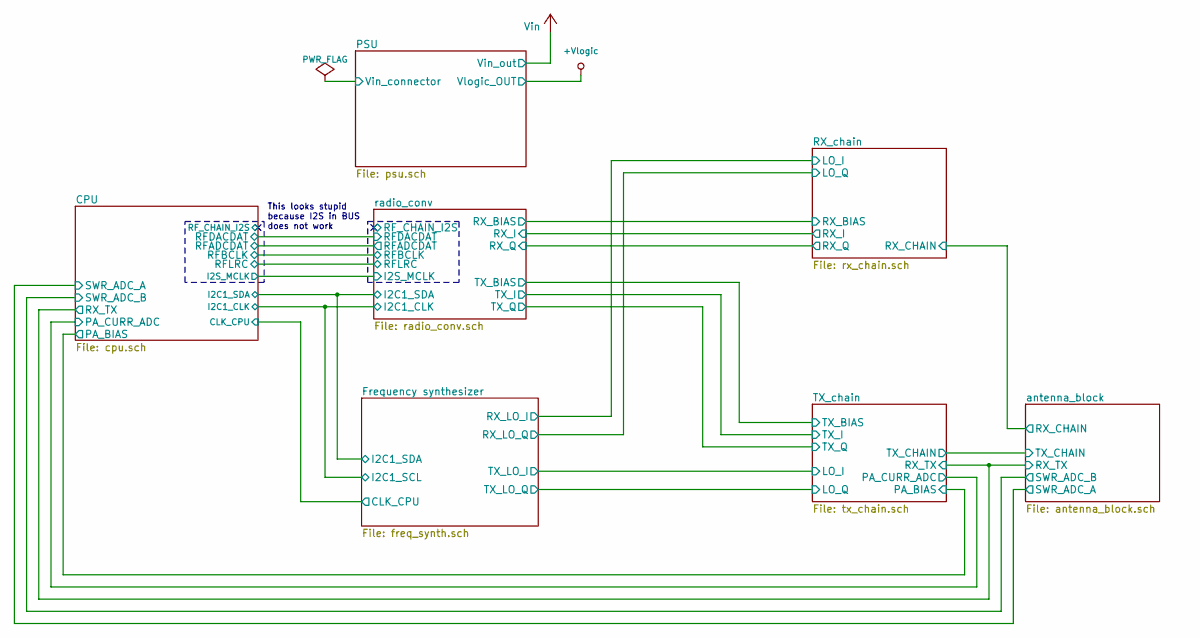
[picture p15: schematic dodekaedri.sch, Block layer]

Notes on the sheet:
This looks stupid because I2S in BUS does not work

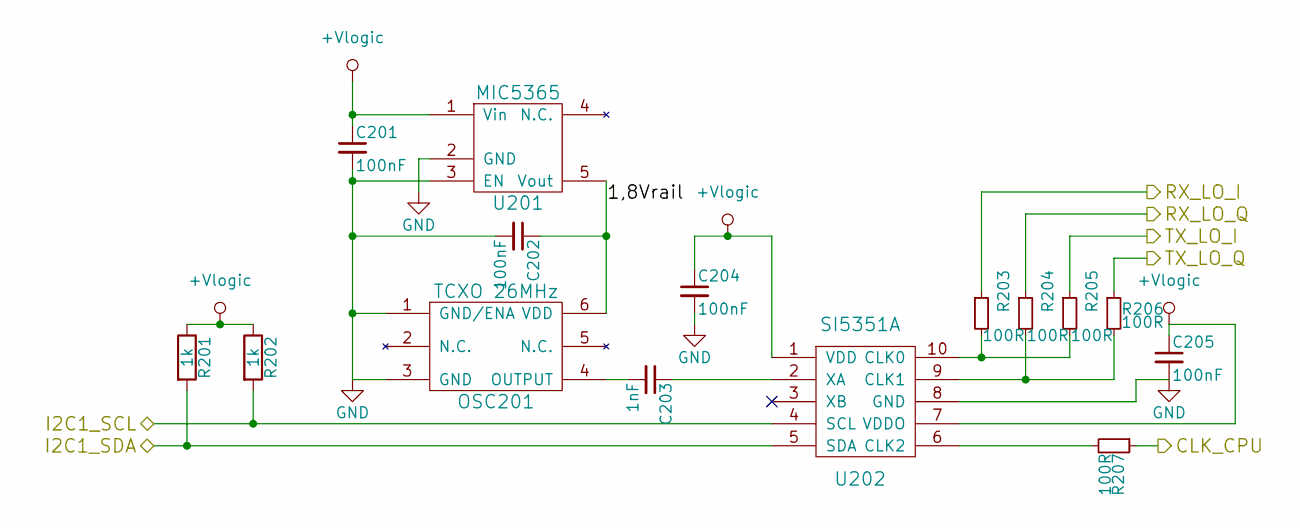
[picture p16: schematic freq_synth.sch, Frequency synthesizer for LOs and CPU clock generation]

Parts:
C201, C202, C204, C205: 100nF; C_0805_HandSoldering
C203: 1nF; C_0805_HandSoldering
OSC201: TCXO 26MHz; TCXO_1.5x2mm
R201, R202: 1k; R_0805_HandSoldering
R203, R204, R205, R206, R207: 100R; R_0805_HandSoldering
U201: MIC5365; SOT-23-5
U202: SI5351A; MSOP-10_3x3mm_Pitch0.5mm

Connections:
+Vlogic: C201.1, C204.1, C205.1, R201.1, R202.1, U201.1 (Vin), U202.1 (VDD), U202.7 (VDDO); also elsewhere on the board
/CPU/CLK_CPU: R207.1; also elsewhere on the board
/CPU/I2C1_CLK: R202.2, U202.4 (SCL); also elsewhere on the board
/CPU/I2C1_SDA: R201.2, U202.5 (SDA); also elsewhere on the board
/Frequency synthesizer/1,8Vrail: C202.1, OSC201.6 (VDD), U201.5 (Vout)
/RX_chain/LO_I: R203.1; also elsewhere on the board
/RX_chain/LO_Q: R204.1; also elsewhere on the board
/TX_chain/LO_I: R205.1; also elsewhere on the board
/TX_chain/LO_Q: R206.1; also elsewhere on the board
GND: C201.2, C202.2, C204.2, C205.2, OSC201.1 (GND/ENA), OSC201.3 (GND), U201.2 (GND), U201.3 (EN), U202.8 (GND); also elsewhere on the board
unnamed: C203.1, U202.2 (XA)
unnamed: C203.2, OSC201.4 (OUTPUT)
unnamed: R203.2, R205.2, U202.10 (CLK0)
unnamed: R204.2, R206.2, U202.9 (CLK1)
unnamed: R207.2, U202.6 (CLK2)

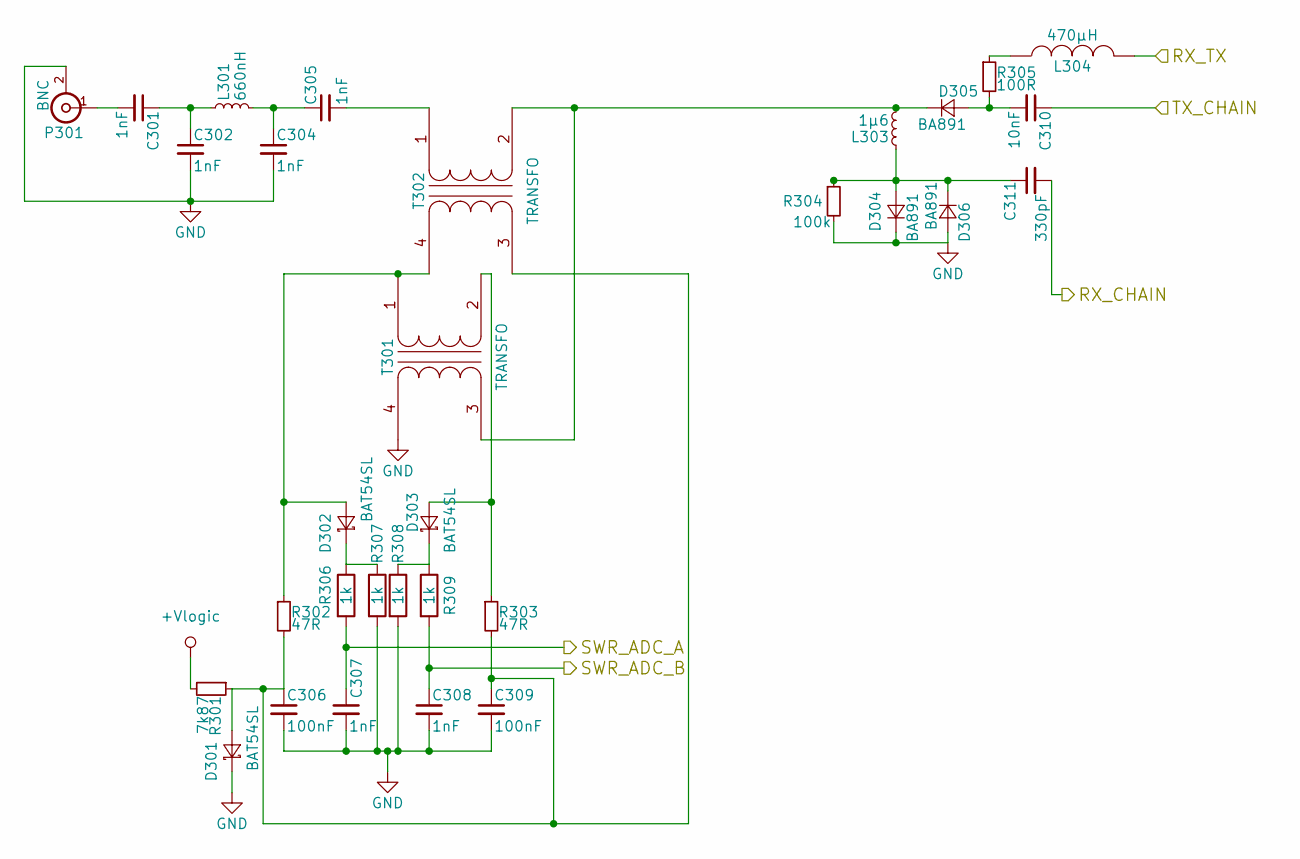
[picture p17: schematic antenna_block.sch, Antenna block, SWR-meter and RXTX switch]

Parts:
C301, C302, C304, C305, C307, C308: 1nF; C_0805_HandSoldering
C306, C309: 100nF; C_0805_HandSoldering
C310: 10nF; C_0805_HandSoldering
C311: 330pF; C_0805_HandSoldering
D301, D302, D303: BAT54SL; SOT-23_HS_2-1-3
D304, D305, D306: BA891; SOD-523
L301: 660nH; Neosid_Air-Coil_SML_5turn_HDM0531A
L303: 1µ6; Neosid_Air-Coil_SML_5turn_HDM0531A
L304: 470µH; SMT_1007
P301: BNC; BNC_right_angle
R301: 7k87; R_0805_HandSoldering
R302, R303: 47R; R_0805_HandSoldering
R304: 100k; R_0805_HandSoldering
R305: 100R; R_0805_HandSoldering
R306, R307, R308, R309: 1k; R_0805_HandSoldering
T301, T302: TRANSFO; TRANSF_pads

Connections:
+Vlogic: R301.2; also elsewhere on the board
/CPU/RX_TX: L304.2; also elsewhere on the board
/CPU/SWR_ADC_A: C307.1, R306.2; also elsewhere on the board
/CPU/SWR_ADC_B: C308.1, R309.2; also elsewhere on the board
/RX_chain/RX_CHAIN: C311.2; also elsewhere on the board
/TX_chain/TX_CHAIN: C310.1; also elsewhere on the board
GND: C302.2, C304.2, C306.2, C307.2, C308.2, C309.2, D301.1 (K), D304.1 (K), D306.2 (A), P301.2 (Ext), R304.2, R307.2, R308.2, T301.4 (SB); also elsewhere on the board
unnamed: C301.1, C302.1, L301.1
unnamed: C301.2, P301.1 (In)
unnamed: C304.1, C305.1, L301.2
unnamed: C305.2, T302.1 (AA)
unnamed: C306.1, C309.1, D301.2 (A), R301.1, R302.2, R303.2, T302.3 (SA)
unnamed: C310.2, D305.2 (A), R305.2
unnamed: C311.1, D304.2 (A), D306.1 (K), L303.1, R304.1
unnamed: D302.1 (K), R306.1, R307.1
unnamed: D302.2 (A), R302.1, T301.1 (AA), T302.4 (SB)
unnamed: D303.1 (K), R308.1, R309.1
unnamed: D303.2 (A), R303.1, T301.2 (AB)
unnamed: D305.1 (K), L303.2, T301.3 (SA), T302.2 (AB)
unnamed: L304.1, R305.1

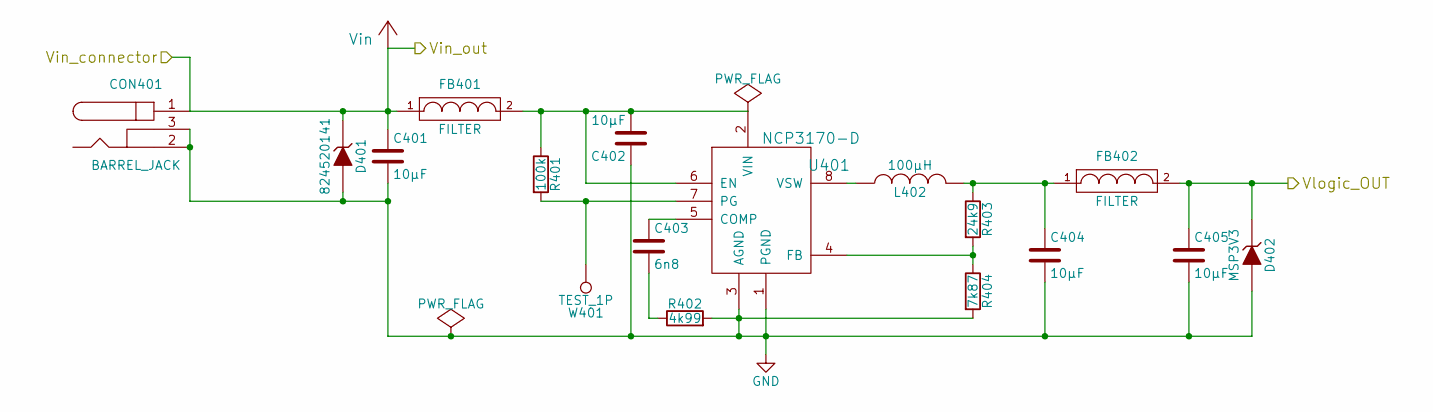
[picture p18: schematic psu.sch, Power supply unit]

Parts:
C401, C402, C404, C405: 10µF; C_0805_HandSoldering
C403: 6n8; C_0805_HandSoldering
CON401: BARREL_JACK
D401: 824520141; SMA_Handsoldering
D402: MSP3V3; Micro_SMP
FB401, FB402: FILTER; R_0805_HandSoldering
L402: 100µH; psu_ind
R401: 100k; R_0805_HandSoldering
R402: 4k99; R_0805_HandSoldering
R403: 24k9; R_0805_HandSoldering
R404: 7k87; R_0805_HandSoldering
U401: NCP3170-D; SOIC-8_3.9x4.9mm_Pitch1.27mm
W401: TEST_1P; Measurement_Point_Round-SMD-Pad_Big

Connections:
+Vlogic: C405.1, D402.1 (K), FB402.2; also elsewhere on the board
GND: C401.2, C402.1, C404.2, C405.2, CON401.2, CON401.3, D401.2 (A), D402.2 (A), R402.2, R404.2, U401.1 (PGND), U401.3 (AGND); also elsewhere on the board
unnamed: C402.2, FB401.2, R401.1, U401.2 (VIN), U401.6 (EN)
unnamed: C403.1, U401.5 (COMP)
unnamed: C403.2, R402.1
unnamed: C404.1, FB402.1, L402.2, R403.1
unnamed: L402.1, U401.8 (VSW)
unnamed: R401.2, U401.7 (PG), W401.1
unnamed: R403.2, R404.1, U401.4 (FB)
Vin_net: C401.1, CON401.1, D401.1 (K), FB401.1; also elsewhere on the board

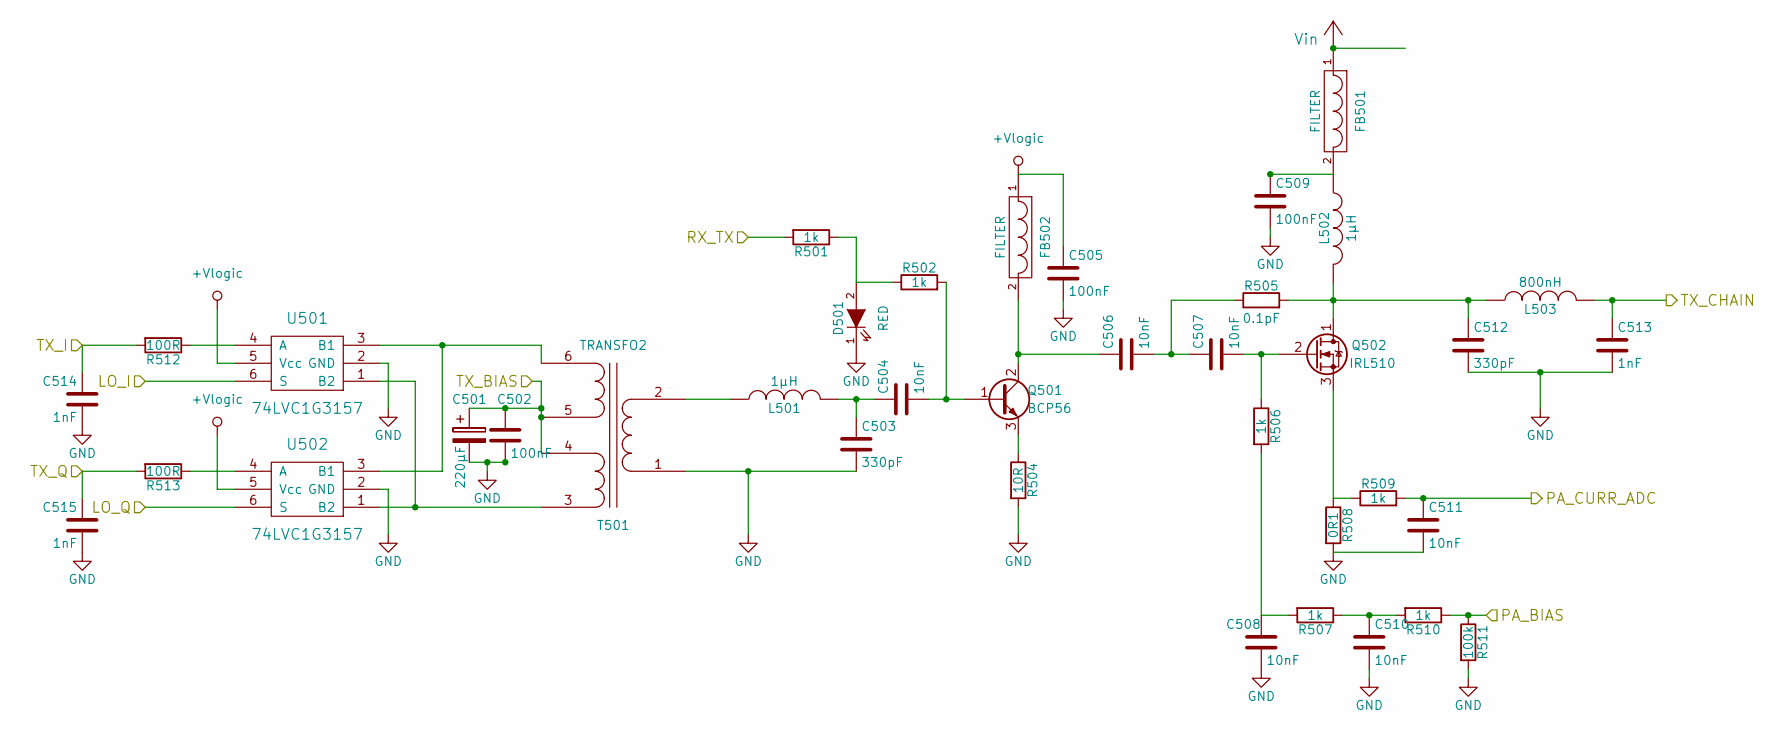
[picture p19: schematic tx_chain.sch, TX chain]

Parts:
C501: 220µF; CAP_6.3x5.8mm
C502, C505, C509: 100nF; C_0805_HandSoldering
C503, C512: 330pF; C_0805_HandSoldering
C504, C506, C507, C508, C510, C511: 10nF; C_0805_HandSoldering
C513, C514, C515: 1nF; C_0805_HandSoldering
D501: RED; LED_0805
FB501, FB502: FILTER; R_0805_HandSoldering
L501, L502: 1µH; Neosid_Air-Coil_SML_5turn_HDM0531A
L503: 800nH; Neosid_Air-Coil_SML_5turn_HDM0531A
Q501: BCP56; SOT-223
Q502: IRL510; TO-220_Neutral123_Vertical
R501, R502, R506, R507, R509, R510: 1k; R_0805_HandSoldering
R504: 10R; R_0805_HandSoldering
R505: 0.1pF; R_0805_HandSoldering
R508: 0R1; R_0805_HandSoldering
R511: 100k; R_0805_HandSoldering
R512, R513: 100R; R_0805_HandSoldering
T501: TRANSFO2; transf_5_pin
U501, U502: 74LVC1G3157; SOT-23-6_Handsoldering

Connections:
+Vlogic: C505.1, FB502.1, U501.5 (Vcc), U502.5 (Vcc); also elsewhere on the board
/CPU/PA_BIAS: R510.1, R511.1; also elsewhere on the board
/CPU/PA_CURR_ADC: C511.1, R509.2; also elsewhere on the board
/CPU/RX_TX: R501.2; also elsewhere on the board
/TX_chain/LO_I: U501.6 (S); also elsewhere on the board
/TX_chain/LO_Q: U502.6 (S); also elsewhere on the board
/TX_chain/TX_BIAS: C501.1, C502.1, T501.4 (SB), T501.5 (SC); also elsewhere on the board
/TX_chain/TX_CHAIN: C513.1, L503.2; also elsewhere on the board
/TX_chain/TX_I: C514.1, R512.2; also elsewhere on the board
/TX_chain/TX_Q: C515.1, R513.2; also elsewhere on the board
GND: C501.2, C502.2, C503.2, C505.2, C508.2, C509.2, C510.2, C511.2, C512.2, C513.2, C514.2, C515.2, D501.1 (K), R504.2, R508.2, R511.2, T501.1 (AA), U501.2 (GND), U502.2 (GND); also elsewhere on the board
unnamed: C503.1, C504.1, L501.2
unnamed: C504.2, Q501.1 (B), R502.2
unnamed: C506.1, FB502.2, Q501.2 (C)
unnamed: C506.2, C507.1, R505.1
unnamed: C507.2, Q502.2 (G), R506.1
unnamed: C508.1, R506.2, R507.2
unnamed: C509.1, FB501.2, L502.1
unnamed: C510.1, R507.1, R510.2
unnamed: C512.1, L502.2, L503.1, Q502.1 (D), R505.2
unnamed: D501.2 (A), R501.1, R502.1
unnamed: L501.1, T501.2 (AB)
unnamed: Q501.3 (E), R504.1
unnamed: Q502.3 (S), R508.1, R509.1
unnamed: R512.1, U501.4 (A)
unnamed: R513.1, U502.4 (A)
unnamed: T501.3 (SA), U501.1 (B2), U502.1 (B2)
unnamed: T501.6 (SD), U501.3 (B1), U502.3 (B1)
Vin_net: FB501.1; also elsewhere on the board

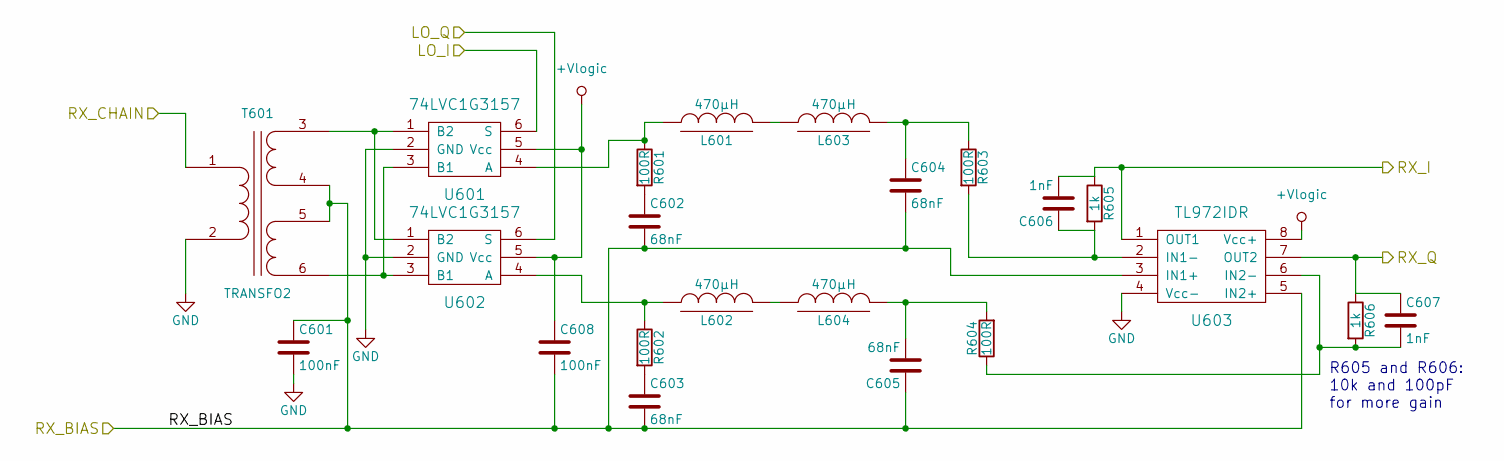
[picture p20: schematic rx_chain.sch, RX chain]

Parts:
C601, C608: 100nF; C_0805_HandSoldering
C602, C603, C604, C605: 68nF; C_0805_HandSoldering
C606, C607: 1nF; C_0805_HandSoldering
L601, L602, L603, L604: 470µH; SMT_1007
R601, R602, R603, R604: 100R; R_0805_HandSoldering
R605, R606: 1k; R_0805_HandSoldering
T601: TRANSFO2; transf_5_pin
U601, U602: 74LVC1G3157; SOT-23-6_Handsoldering
U603: TL972IDR; SOIC-8_3.9x4.9mm_Pitch1.27mm

Connections:
+Vlogic: C608.1, U601.5 (Vcc), U602.5 (Vcc), U603.8 (Vcc+); also elsewhere on the board
/RX_chain/LO_I: U601.6 (S); also elsewhere on the board
/RX_chain/LO_Q: U602.6 (S); also elsewhere on the board
/RX_chain/RX_BIAS: C601.1, C602.2, C603.2, C604.2, C605.1, C608.2, T601.4 (SB), T601.5 (SC), U603.3 (IN1+), U603.5 (IN2+); also elsewhere on the board
/RX_chain/RX_CHAIN: T601.1 (AA); also elsewhere on the board
/RX_chain/RX_I: C606.2, R605.1, U603.1 (OUT1); also elsewhere on the board
/RX_chain/RX_Q: C607.1, R606.1, U603.7 (OUT2); also elsewhere on the board
GND: C601.2, T601.2 (AB), U601.2 (GND), U602.2 (GND), U603.4 (Vcc-); also elsewhere on the board
unnamed: C602.1, R601.2
unnamed: C603.1, R602.2
unnamed: C604.1, L603.2, R603.1
unnamed: C605.2, L604.2, R604.2
unnamed: C606.1, R603.2, R605.2, U603.2 (IN1-)
unnamed: C607.2, R604.1, R606.2, U603.6 (IN2-)
unnamed: L601.1, R601.1, U601.4 (A)
unnamed: L601.2, L603.1
unnamed: L602.1, R602.1, U602.4 (A)
unnamed: L602.2, L604.1
unnamed: T601.3 (SA), U601.1 (B2), U602.1 (B2)
unnamed: T601.6 (SD), U601.3 (B1), U602.3 (B1)

Notes on the sheet:
R605 and R606: 10k and 100pF for more gain

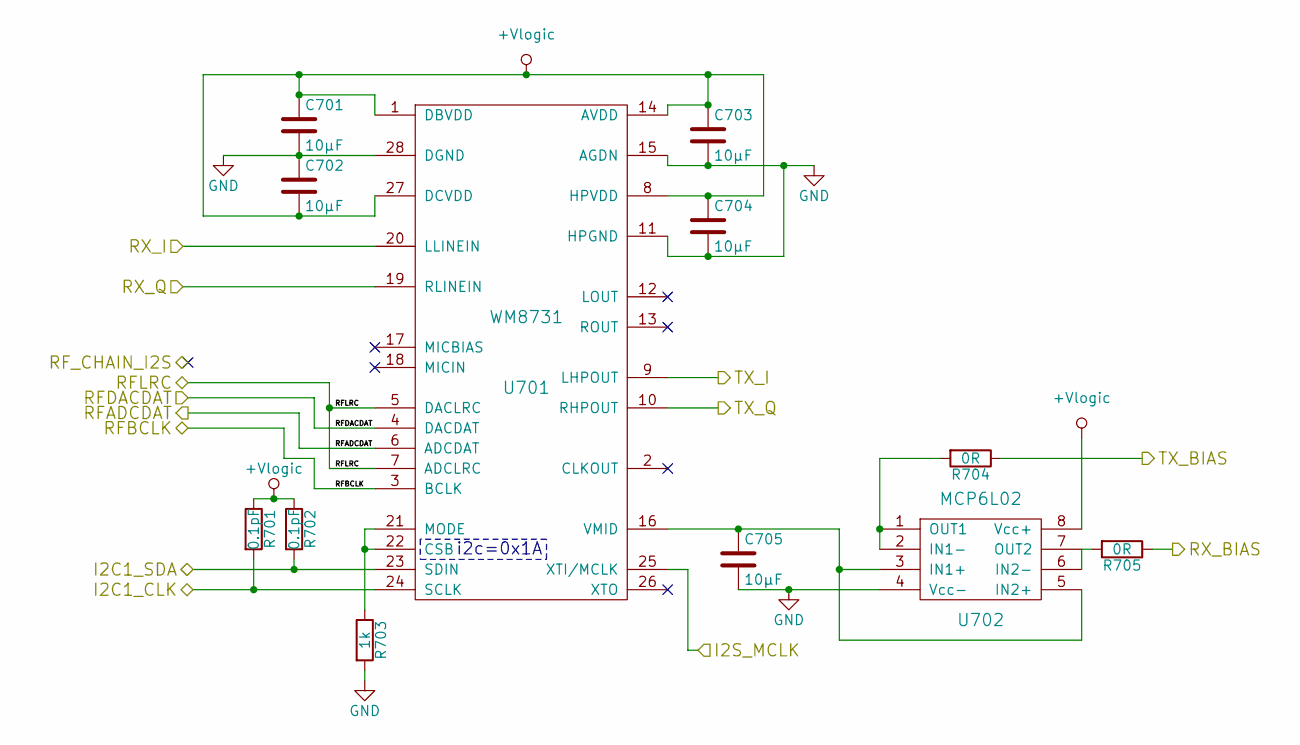
[picture p21: schematic radio_conv.sch, RF chain ADC/DAC]

Parts:
C701, C702, C703, C704, C705: 10µF; C_0805_HandSoldering
R701, R702: 0.1pF; R_0805_HandSoldering
R703: 1k; R_0805_HandSoldering
R704, R705: 0R; R_0805_HandSoldering
U701: WM8731; SSOP-28_5.3x10.2mm_Pitch0.65mm
U702: MCP6L02; SOIC-8_3.9x4.9mm_Pitch1.27mm

Connections:
+Vlogic: C701.1, C702.2, C703.1, C704.1, R701.1, R702.1, U701.1 (DBVDD), U701.8 (HPVDD), U701.14 (AVDD), U701.27 (DCVDD), U702.8 (Vcc+); also elsewhere on the board
/CPU/I2C1_CLK: R701.2, U701.24 (SCLK); also elsewhere on the board
/CPU/I2C1_SDA: R702.2, U701.23 (SDIN); also elsewhere on the board
/CPU/I2S_MCLK: U701.25 (XTI/MCLK); also elsewhere on the board
/CPU/RFADCDAT: U701.6 (ADCDAT); also elsewhere on the board
/CPU/RFBCLK: U701.3 (BCLK); also elsewhere on the board
/CPU/RFDACDAT: U701.4 (DACDAT); also elsewhere on the board
/CPU/RFLRC: U701.5 (DACLRC), U701.7 (ADCLRC); also elsewhere on the board
/RX_chain/RX_BIAS: R705.1; also elsewhere on the board
/RX_chain/RX_I: U701.20 (LLINEIN); also elsewhere on the board
/RX_chain/RX_Q: U701.19 (RLINEIN); also elsewhere on the board
/TX_chain/TX_BIAS: R704.1; also elsewhere on the board
/TX_chain/TX_I: U701.9 (LHPOUT); also elsewhere on the board
/TX_chain/TX_Q: U701.10 (RHPOUT); also elsewhere on the board
GND: C701.2, C702.1, C703.2, C704.2, C705.2, R703.2, U701.11 (HPGND), U701.15 (AGDN), U701.28 (DGND), U702.4 (Vcc-); also elsewhere on the board
unnamed: C705.1, U701.16 (VMID), U702.3 (IN1+), U702.5 (IN2+)
unnamed: R703.1, U701.21 (MODE), U701.22 (CSB)
unnamed: R704.2, U702.1 (OUT1), U702.2 (IN1-)
unnamed: R705.2, U702.6 (IN2-), U702.7 (OUT2)

Notes on the sheet:
i2c=0x1A

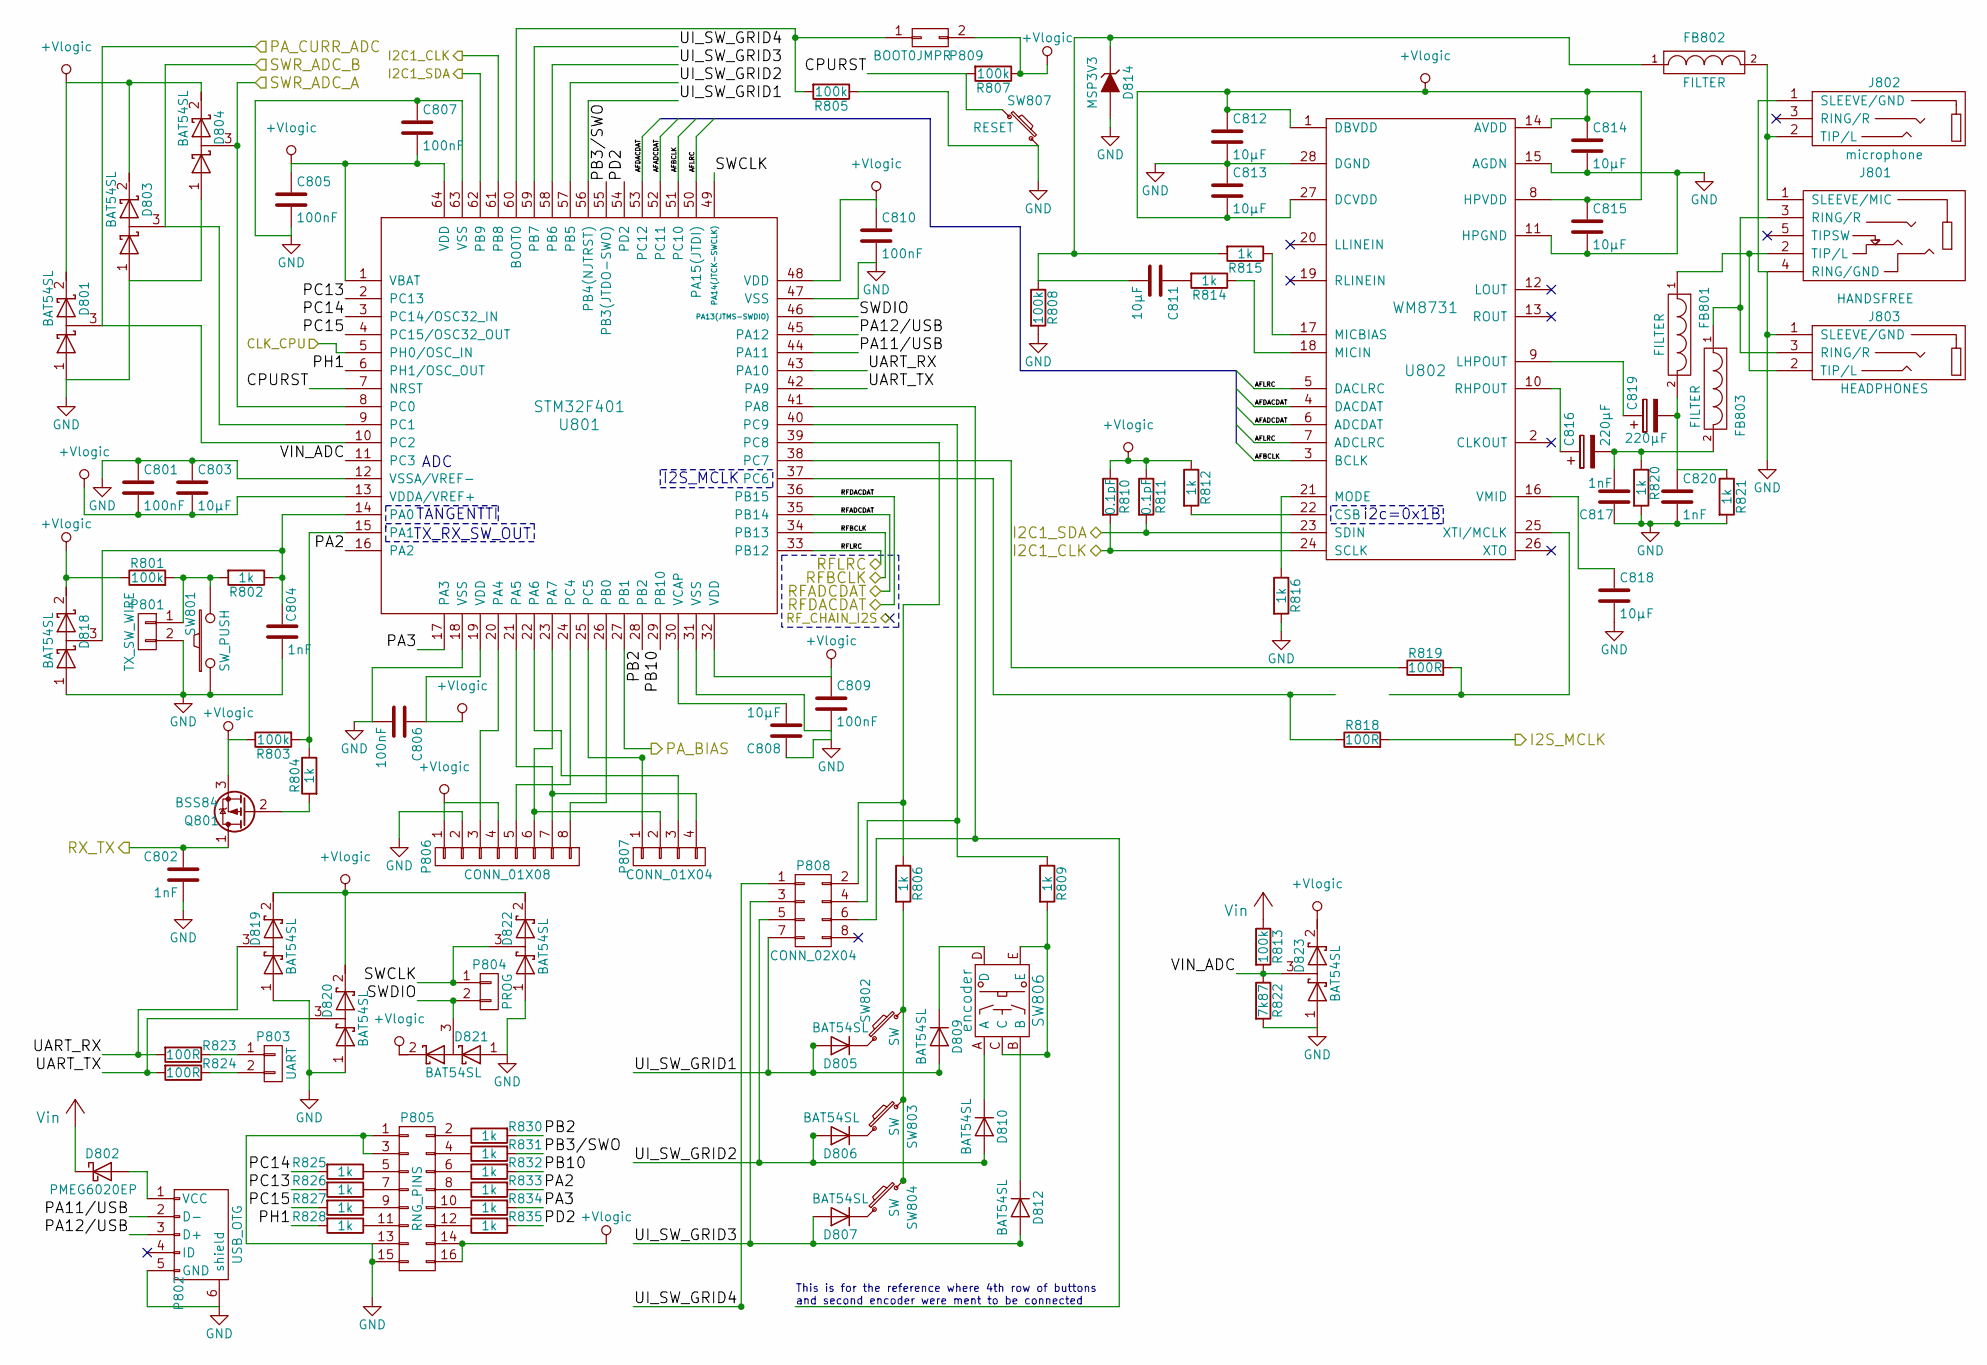
[picture p22: schematic cpu.sch, CPU, UI and AF blocks]

Parts:
C801, C805, C806, C807, C809, C810: 100nF; C_0805_HandSoldering
C802, C804, C817, C820: 1nF; C_0805_HandSoldering
C803, C808, C811, C812, C813, C814, C815, C818: 10µF; C_0805_HandSoldering
C816, C819: 220µF; CAP_6.3x5.8mm
D801, D803, D804, D818, D819, D820, D821, D822, D823: BAT54SL; SOT-23_Handsoldering
D802: PMEG6020EP; D_0805
D805, D806, D807, D809, D810, D812: BAT54SL; SOT-23_HS_2-1-3
D814: MSP3V3; Micro_SMP
FB801, FB802, FB803: FILTER; R_0805_HandSoldering
J801: HANDSFREE; TRRS_jack
J802: microphone
J803: HEADPHONES
P801: TX_SW_WIRE; AK300-2
P802: USB_OTG; USB_Micro-B
P803: UART; Pin_Header_Straight_1x02
P804: PROG; Pin_Header_Straight_1x02
P805: RNG_PINS; Pin_Header_Straight_2x08
P806: CONN_01X08; Pin_Header_Straight_1x08
P807: CONN_01X04; Pin_Header_Straight_1x04
P808: CONN_02X04; Pin_Header_Straight_2x04
P809: BOOT0JMPR; Pin_Header_Straight_1x02
Q801: BSS84; SOT-23_Handsoldering
R801, R803, R805, R807, R808, R813: 100k; R_0805_HandSoldering
R802, R804, R806, R809, R812, R814, R815, R816, R820, R821, R825, R826, R827, R828, R830, R831, R832, R833, R834, R835: 1k; R_0805_HandSoldering
R810, R811: 0.1pF; R_0805_HandSoldering
R818, R819, R823, R824: 100R; R_0805_HandSoldering
R822: 7k87; R_0805_HandSoldering
SW801: SW_PUSH; SW_SPST_B3SL-1002P
SW802, SW803, SW804: SW; SW_SPST_B3SL-1002P
SW806: encoder
SW807: RESET; SW_SPST_B3SL-1002P
U801: STM32F401; LQFP-64_10x10mm_Pitch0.5mm
U802: WM8731; SSOP-28_5.3x10.2mm_Pitch0.65mm

Connections:
+Vlogic: C801.2, C803.2, C805.1, C806.1, C807.2, C809.1, C810.1, C812.1, C813.2, C814.1, C815.1, D801.2 (K), D803.2 (K), D804.2 (K), D818.2 (K), D819.2 (K), D820.2 (K), D821.2 (K), D822.2 (K), D823.2 (K), P805.14, P805.16, P806.1, P806.4, P809.2, Q801.3 (S), R801.1, R803.1, R807.1, R810.1, R811.1, R812.1, U801.1 (VBAT), U801.13 (VDDA/VREF+), U801.19 (VDD), U801.32 (VDD), U801.48 (VDD), U801.64 (VDD), U802.1 (DBVDD), U802.8 (HPVDD), U802.14 (AVDD), U802.27 (DCVDD); also elsewhere on the board
/CPU/AFADCDAT: U801.52 (PC11), U802.6 (ADCDAT)
/CPU/AFBCLK: U801.51 (PC10), U802.3 (BCLK)
/CPU/AFDACDAT: U801.53 (PC12), U802.4 (DACDAT)
/CPU/AFLRC: U801.50 (PA15(JTDI)), U802.5 (DACLRC), U802.7 (ADCLRC)
/CPU/CLK_CPU: U801.5 (PH0/OSC_IN); also elsewhere on the board
/CPU/CPURST: R807.2, SW807.1, U801.7 (NRST)
/CPU/I2C1_CLK: R810.2, U801.61 (PB8), U802.24 (SCLK); also elsewhere on the board
/CPU/I2C1_SDA: R811.2, U801.62 (PB9), U802.23 (SDIN); also elsewhere on the board
/CPU/I2S_MCLK: R818.2; also elsewhere on the board
/CPU/PA2: R833.2, U801.16 (PA2)
/CPU/PA3: R834.2, U801.17 (PA3)
/CPU/PA11/USB: P802.2 (D-), U801.44 (PA11)
/CPU/PA12/USB: P802.3 (D+), U801.45 (PA12)
/CPU/PA_BIAS: U801.27 (PB1); also elsewhere on the board
/CPU/PA_CURR_ADC: D801.3 (common), U801.10 (PC2); also elsewhere on the board
/CPU/PB2: R830.2, U801.28 (PB2)
/CPU/PB3/SWO: R831.2, U801.55 (PB3(JTDO-SWO))
/CPU/PB10: R832.2, U801.29 (PB10)
/CPU/PC13: R826.2, U801.2 (PC13)
/CPU/PC14: R825.2, U801.3 (PC14/OSC32_IN)
/CPU/PC15: R827.2, U801.4 (PC15/OSC32_OUT)
/CPU/PD2: R835.2, U801.54 (PD2)
/CPU/PH1: R828.2, U801.6 (PH1/OSC_OUT)
/CPU/RFADCDAT: U801.35 (PB14); also elsewhere on the board
/CPU/RFBCLK: U801.34 (PB13); also elsewhere on the board
/CPU/RFDACDAT: U801.36 (PB15); also elsewhere on the board
/CPU/RFLRC: U801.33 (PB12); also elsewhere on the board
/CPU/RX_TX: C802.1, Q801.1 (D); also elsewhere on the board
/CPU/SWCLK: D822.3 (common), P804.1, U801.49 (PA14(JTCK-SWCLK))
/CPU/SWDIO: D821.3 (common), P804.2, U801.46 (PA13(JTMS-SWDIO))
/CPU/SWR_ADC_A: D804.3 (common), U801.8 (PC0); also elsewhere on the board
/CPU/SWR_ADC_B: D803.3 (common), U801.9 (PC1); also elsewhere on the board
/CPU/UART_RX: D819.3 (common), R823.2, U801.43 (PA10)
/CPU/UART_TX: D820.3 (common), R824.2, U801.42 (PA9)
/CPU/UI_SW_GRID1: D805.2 (A), D809.2 (A), P808.7, U801.56 (PB4(NJTRST))
/CPU/UI_SW_GRID2: D806.2 (A), D810.2 (A), P808.5, U801.57 (PB5)
/CPU/UI_SW_GRID3: D807.2 (A), D812.2 (A), P808.3, U801.58 (PB6)
/CPU/UI_SW_GRID4: P808.1, U801.59 (PB7)
/CPU/VIN_ADC: D823.3 (common), R813.2, R822.1, U801.11 (PC3)
GND: C801.1, C802.2, C803.1, C804.2, C805.2, C806.2, C807.1, C808.1, C809.2, C810.2, C812.2, C813.1, C814.2, C815.2, C817.2, C818.2, C820.2, D801.1 (A), D803.1 (A), D804.1 (A), D814.2 (A), D818.1 (A), D819.1 (A), D820.1 (A), D821.1 (A), D822.1 (A), D823.1 (A), J801.4 (RING/GND), J802.1 (SLEEVE/GND), J803.1 (SLEEVE/GND), P801.2, P802.5 (GND), P802.6 (shield), P805.1, P805.3, P805.13, P805.15, P806.2, R805.1, R808.2, R816.2, R820.2, R821.2, R822.2, SW801.1, SW807.2, U801.12 (VSSA/VREF-), U801.18 (VSS), U801.31 (VSS), U801.47 (VSS), U801.63 (VSS), U802.11 (HPGND), U802.15 (AGDN), U802.28 (DGND); also elsewhere on the board
unnamed: C804.1, D818.3 (common), R802.1, U801.14 (PA0)
unnamed: C808.2, U801.30 (VCAP)
unnamed: C811.1, R814.2
unnamed: C811.2, D814.1 (K), FB802.1, R808.1, R815.2
unnamed: C816.1, U802.10 (RHPOUT)
unnamed: C816.2, C817.1, FB803.2, R820.1
unnamed: C818.1, U802.16 (VMID)
unnamed: C819.1, U802.9 (LHPOUT)
unnamed: C819.2, C820.1, FB801.2, R821.1
unnamed: D802.2 (A), P802.1 (VCC)
unnamed: D805.1 (K), SW802.1
unnamed: D806.1 (K), SW803.1
unnamed: D807.1 (K), SW804.1
unnamed: D809.1 (K), SW806.D
unnamed: D810.1 (K), SW806.A
unnamed: D812.1 (K), SW806.B
unnamed: FB801.1, J801.2 (TIP/L), J803.2 (TIP/L)
unnamed: FB802.2, J801.1 (SLEEVE/MIC), J802.2 (TIP/L)
unnamed: FB803.1, J801.3 (RING/R), J803.3 (RING/R)
unnamed: P801.1, R801.2, R802.2, SW801.2
unnamed: P803.1, R823.1
unnamed: P803.2, R824.1
unnamed: P805.2, R830.1
unnamed: P805.4, R831.1
unnamed: P805.5, R825.1
unnamed: P805.6, R832.1
unnamed: P805.7, R826.1
unnamed: P805.8, R833.1
unnamed: P805.9, R827.1
unnamed: P805.10, R834.1
unnamed: P805.11, R828.1
unnamed: P805.12, R835.1
unnamed: P806.3, U801.20 (PA4)
unnamed: P806.5, U801.24 (PC4)
unnamed: P806.6, P807.2, U801.23 (PA7)
unnamed: P806.7, P807.4, U801.21 (PA5)
unnamed: P806.8, U801.26 (PB0)
unnamed: P807.1, U801.25 (PC5)
unnamed: P807.3, U801.22 (PA6)
unnamed: P808.2, R806.1, U801.39 (PC8)
unnamed: P808.4, R809.1, U801.40 (PC9)
unnamed: P808.6, U801.41 (PA8)
unnamed: P809.1, R805.2, U801.60 (BOOT0)
unnamed: Q801.2 (G), R804.2
unnamed: R803.2, R804.1, U801.15 (PA1)
unnamed: R806.2, SW802.2, SW803.2, SW804.2
unnamed: R809.2, SW806.C, SW806.E
unnamed: R812.2, U802.22 (CSB)
unnamed: R814.1, U802.18 (MICIN)
unnamed: R815.1, U802.17 (MICBIAS)
unnamed: R816.1, U802.21 (MODE)
unnamed: R818.1, U801.37 (PC6)
unnamed: R819.1, U801.38 (PC7)
unnamed: R819.2, U802.25 (XTI/MCLK)
Vin_net: D802.1 (K), R813.1; also elsewhere on the board

Notes on the sheet:
i2c=0x1B
I2S_MCLK
ADC
TANGENTTI
TX_RX_SW_OUT
This is for the reference where 4th row of buttons and second encoder were ment to be connected

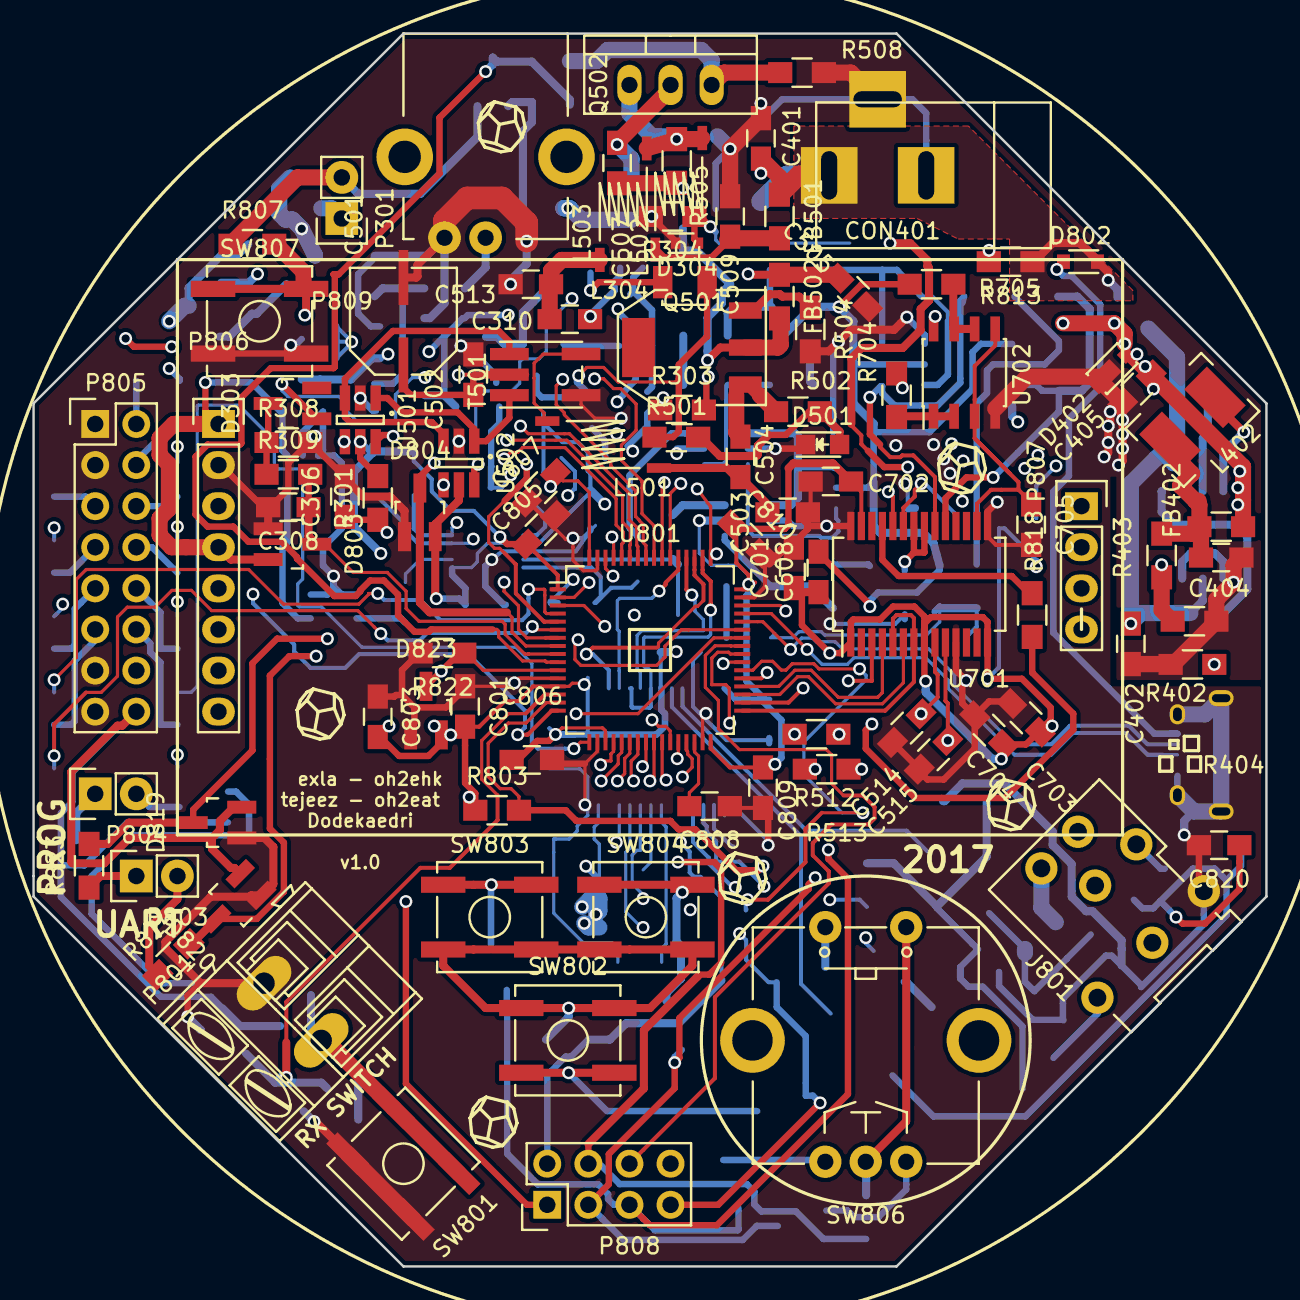
[picture p23: board dodekaedri.kicad_pcb from above]

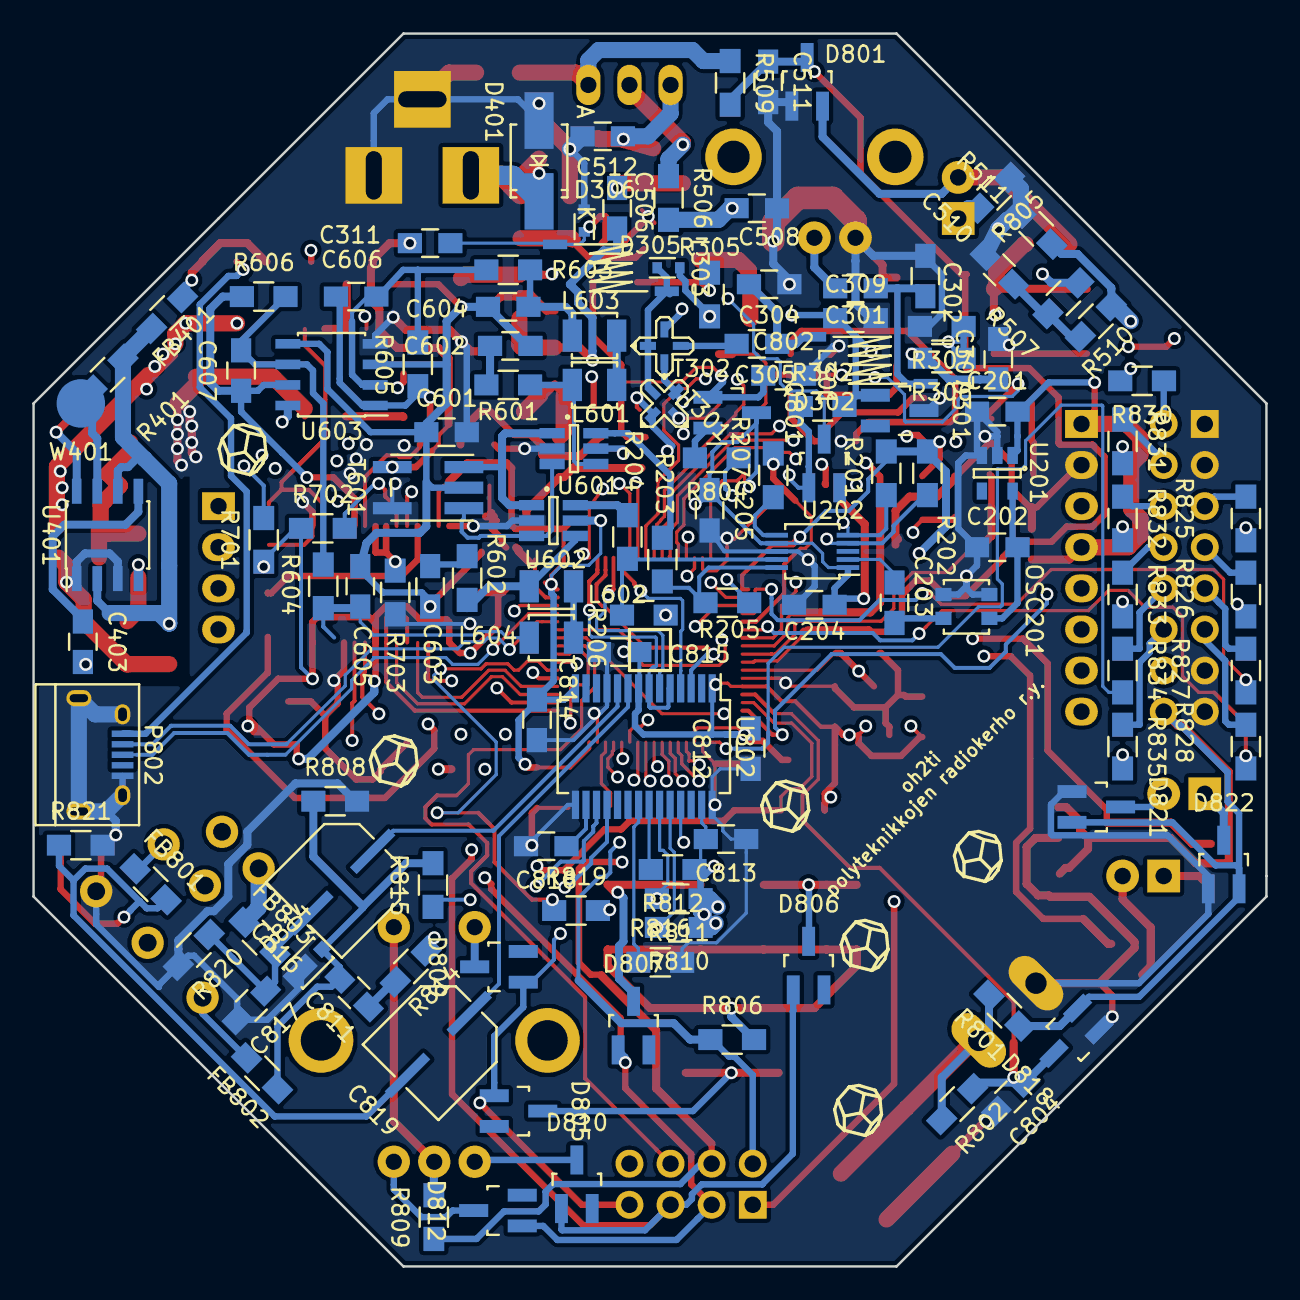
[picture p24: board dodekaedri.kicad_pcb from below]

Board: 4 copper layers, 76.2 x 76.2 mm, 227 parts (128 on the bottom side), 167 nets.
