e-xla/dodekaedri/(commit log)

2016-09-20 initial schematic commit
    [dodekaedri.kicad_pcb, dodekaedri.sch]
2016-09-20 Added initial schematic for frequency synthesizer
    [dodekaedri.sch]
2016-09-21 Added antenna+SWR+antenna switch schematic block
    [dodekaedri.sch]
2016-09-21 Converted schematic into hierarchial one to maintain clarity and to fit whole schematic somewhere
    [antenna_block.sch, dodekaedri.sch, freq_synth.sch]
2016-09-21 Added dodekaedri.pdf which is plotted schematic drawings for viewing them without kicad
    [dodekaedri.sch]
2016-09-21 Appended README.md in case someone actually finds this project :D
2016-09-22 Added PSU schematic block
    [antenna_block.sch, dodekaedri.sch, freq_synth.sch]
2016-09-22 Actually added psu schematic files under git..
    [psu.sch]
2016-09-22 Added pull-up resistor for PG-pin in psu.sch
    [psu.sch]
2016-09-22 Added opamp and adc/dac schematic symbols
2016-09-22 restructured block layer for branch-fork
    [antenna_block.sch, dodekaedri.sch]
2016-09-22 added rx/tx wm8731 (adc/dac)
    [antenna_block.sch, dodekaedri.sch, psu.sch]
2016-09-22 Added TX chain schematic block and Vin netlist for input power_flag
    [antenna_block.sch, dodekaedri.sch, freq_synth.sch, psu.sch, tx_chain.sch]
2016-09-22 honed multiple schematics
    [dodekaedri.sch, tx_chain.sch]
2016-09-22 Moved review images into folder pcb_plots and redrew schemaplots
2016-09-22 LED blink for STM32F401RE Nucleo board
2016-09-22 Added RX chain. also modified and cleand up other schemas
    [antenna_block.sch, dodekaedri.sch, freq_synth.sch, psu.sch, radio_conv.sch, rx_chain.sch, tx_chain.sch]
2016-09-22 Added biases for RX and TX chains where needed
    [antenna_block.sch, dodekaedri.sch, freq_synth.sch, psu.sch, radio_conv.sch, rx_chain.sch, tx_chain.sch]
2016-09-24 Added initial CPU block and fixed bugs from other sheets
    [antenna_block.sch, cpu.sch, dodekaedri.sch, freq_synth.sch, psu.sch, radio_conv.sch, rx_chain.sch, tx_chain.sch]
2016-09-24 Updated schematic plot
2016-09-24 defined more component values
    [antenna_block.sch]
2016-09-24 Updated schematic plot accordingly
2016-09-26 Allocated CPU some pins and made minor adjustments here and there
    [antenna_block.sch, cpu.sch, dodekaedri.sch, radio_conv.sch, tx_chain.sch]
2016-09-26 Made some minor adjustments and replotted schematic .pdf
    [cpu.sch, psu.sch, rx_chain.sch, tx_chain.sch]
2016-09-26 Fixed broken wire in tx_chain.sch
    [tx_chain.sch]
2016-09-27 fixed some bugs
    [cpu.sch, rx_chain.sch, tx_chain.sch]
2016-09-27 Fixed 8/11 of issue #4
    [cpu.sch, psu.sch, radio_conv.sch]
2016-09-27 added button grid with two pressable rotary encoders for UI block and replotted
    [cpu.sch]
2016-09-27 Added annotation so willing prove readers can reference components more easily
    [antenna_block.sch, cpu.sch, dodekaedri.sch, freq_synth.sch, psu.sch, radio_conv.sch, rx_chain.sch, tx_chain.sch]
2016-09-29 fixed some ERC errors
    [antenna_block.sch, cpu.sch, dodekaedri.sch, freq_synth.sch, psu.sch, radio_conv.sch, rx_chain.sch, tx_chain.sch]
2016-09-29 fixed some more ERC errors
    [antenna_block.sch, cpu.sch, dodekaedri.sch, freq_synth.sch, psu.sch, radio_conv.sch, rx_chain.sch, tx_chain.sch]
2016-09-29 Upgraded schematic to version 1.0 and generated initial BOM
    [antenna_block.sch, cpu.sch, dodekaedri.csv, dodekaedri.sch, freq_synth.sch, psu.sch, radio_conv.sch, rx_chain.sch]
2016-09-29 Linked first components to footprints and updated schematic plot
    [antenna_block.sch, cpu.sch, dodekaedri.sch, freq_synth.sch, psu.sch, radio_conv.sch, rx_chain.sch, tx_chain.sch]
2016-09-30 Added more electrical protections
    [cpu.sch]
2016-10-01 Changed SWR microstrip for two transformers and gave missing values for components
    [antenna_block.sch, cpu.sch, dodekaedri.sch, freq_synth.sch, psu.sch, radio_conv.sch, rx_chain.sch, tx_chain.sch]
2016-10-02 Fixed some bugs and annotated rest of the footprints
    [antenna_block.sch, cpu.sch, dodekaedri.sch, freq_synth.sch, psu.sch, radio_conv.sch, rx_chain.sch, tx_chain.sch]
2016-10-02 first iterations of pcb layout
    [dodekaedri.csv]
2016-10-02 save layout _before_ doing drastinc netlist changes
    [dodekaedri.kicad_pcb]
2016-10-02 recommit before doing drastic netlist changes?
    [antenna_block.sch, cpu.sch, dodekaedri.sch, freq_synth.sch, psu.sch, radio_conv.sch, rx_chain.sch, tx_chain.sch]
2016-10-02 failsafe commit just before recreating netlist
    [cpu.sch, tx_chain.sch]
2016-10-03 15% of layout done.. hopefully
    [cpu.sch, dodekaedri.kicad_pcb, radio_conv.sch, rx_chain.sch, tx_chain.sch]
2016-10-04 halfway through layout
    [antenna_block.sch, cpu.sch, dodekaedri.kicad_pcb, psu.sch, radio_conv.sch, rx_chain.sch, tx_chain.sch]
2016-11-05 one fourth to go... area-wise :D
    [dodekaedri.kicad_pcb]
2016-12-12 some minor advancements
    [dodekaedri.kicad_pcb]
2016-12-27 fixed currently existing layout drc errors
    [dodekaedri.kicad_pcb]
2017-01-06 intermediate save; closing in on the finished layout
    [dodekaedri.csv, dodekaedri.kicad_pcb]
2017-01-06 Again, managed to advance layout a bit
    [dodekaedri.kicad_pcb]
2017-01-08 Quite a few routing bugs fixed and backup-commiting
    [dodekaedri.kicad_pcb]
2017-01-08 All components are placed. GND and +Vlogic copper fills still undone
    [cpu.sch, dodekaedri.kicad_pcb, tx_chain.sch]
2017-01-09 layout done,d
    [dodekaedri.kicad_pcb]
2017-01-09 Added .pdf plots of schematic and layout
2017-01-09 fixed serious schematic and thus layout bug
    [dodekaedri.kicad_pcb, rx_chain.sch]
2017-01-09 Added M2.5 mounting holes
    [dodekaedri.kicad_pcb]
2017-01-19 changed some component values
    [antenna_block.sch, dodekaedri.kicad_pcb, rx_chain.sch]
2017-01-19 Changed TX driver supply voltage to 3.3V
    [cpu.sch, dodekaedri.kicad_pcb, radio_conv.sch, rx_chain.sch, tx_chain.sch]
2017-01-23 finished pcb layout, made some last-minute modifications and plotted schematic, layers, and gerbers
    [dodekaedri.kicad_pcb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]
2017-01-26 regenerated bom
2017-02-07 added up-to-date bom into git
    [bom_v1.csv, dodekaedri.csv]
2017-02-07 added spreadsheet version of the more informative bom in order to iterate component order more easily
    [bom_v1.ods]
2017-02-07 Added mouser part numbers (from some months ago, possibly not the cheapest anymore)
    [bom_v1.ods]
2017-02-07 New mouser links for resistors
    [bom_v1.ods]
2017-02-07 Some more mouser links and other remarks
    [bom_v1.ods]
2017-02-07 More mouser
    [bom_v1.ods]
2017-02-07 Ready for order from mouser
    [bom_v1.ods]
2017-02-07 modified pre-order ammounts into sheet for further information
    [bom_v1.ods]
